kstammits/Mutable/Kinks/pics/pic_rear.jpeg

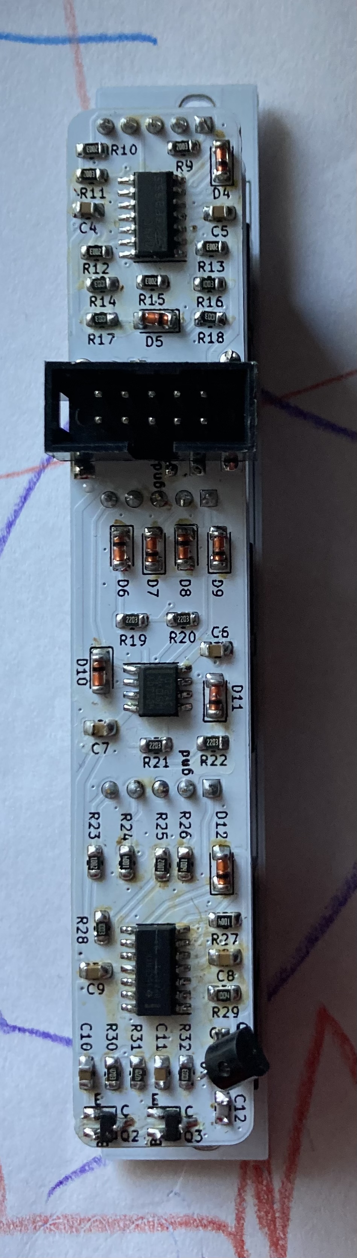
Kinks/pics/pic_rear.jpeg
