kstammits/Mutable/Kinks/pics/pic_face.jpeg

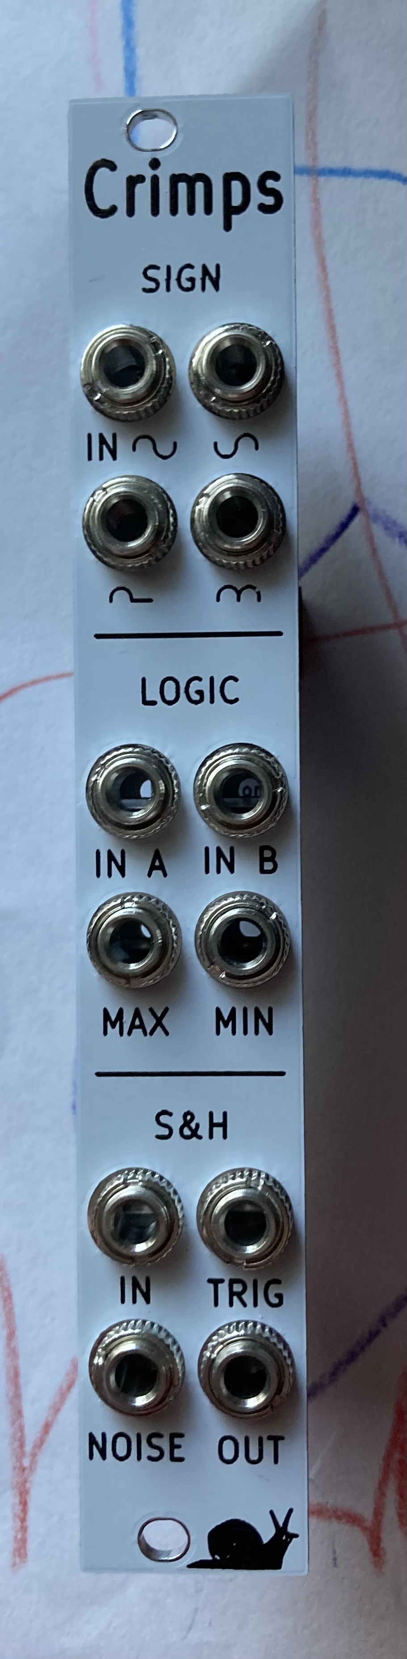
Kinks/pics/pic_face.jpeg
