kstammits/Mutable/Kinks/pics/pic_mg.jpeg

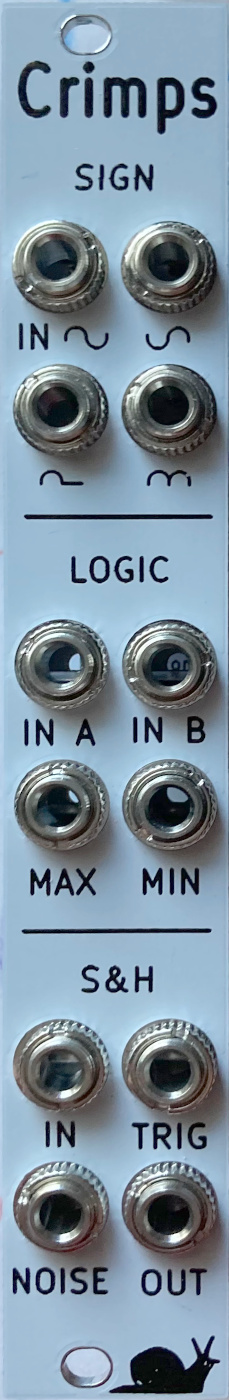
Kinks/pics/pic_mg.jpeg
