kstammits/Mutable/Kinks/pics/pic_side.jpeg

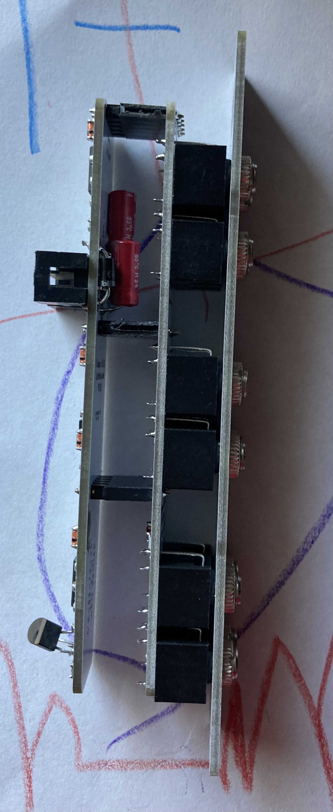
Kinks/pics/pic_side.jpeg
