kstammits/Mutable/Kinks/pics/pic_tri.jpeg

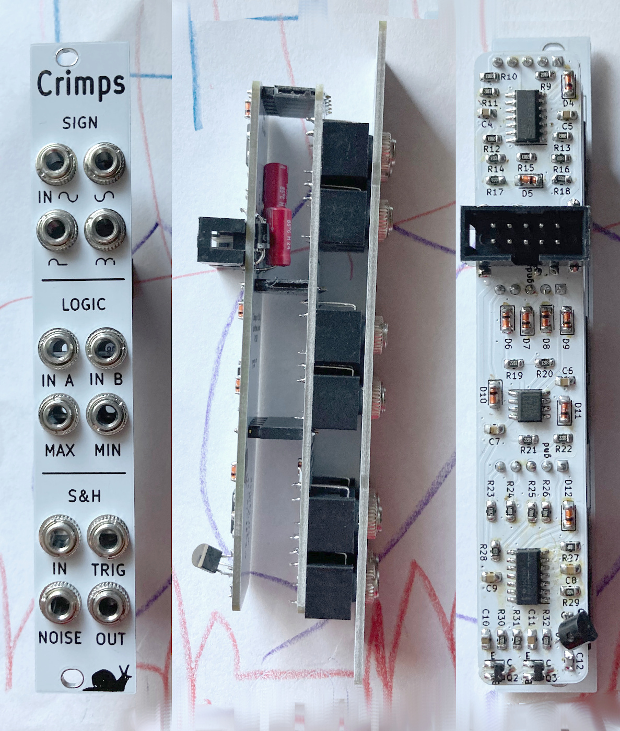
Kinks/pics/pic_tri.jpeg
