kstammits/Mutable/Kinks/pics/Screen Shot 2021-11-17 at 9.47.22 PM.png

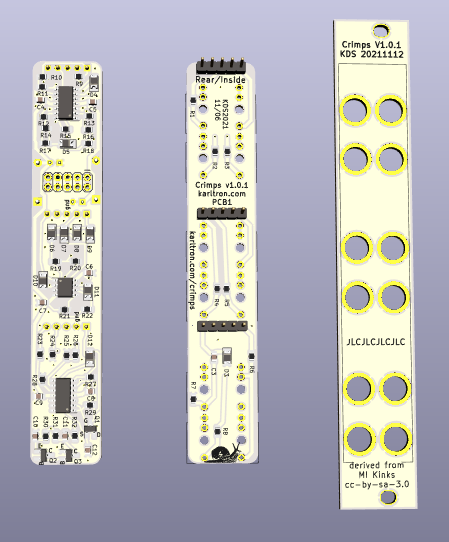
Kinks/pics/Screen Shot 2021-11-17 at 9.47.22 PM.png
