kstammits/Mutable/Shades/mg_shady.png

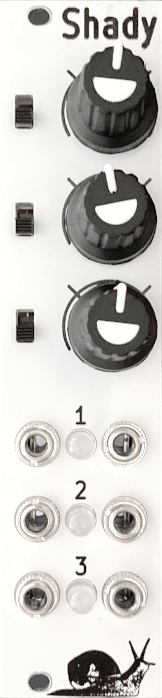
Shades/mg_shady.png
