kstammits/Mutable/Shades/sss_back.png

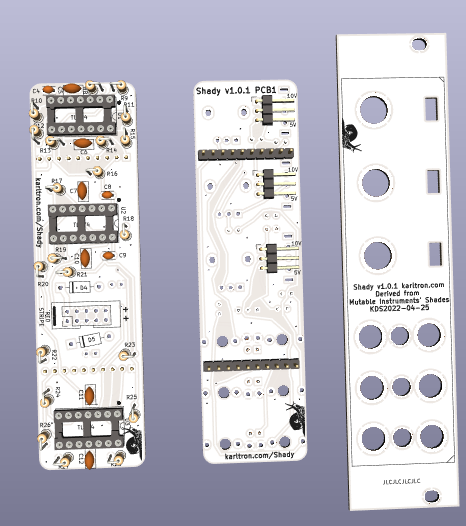
Shades/sss_back.png
