kstammits/Mutable/Shades/sss_front.png

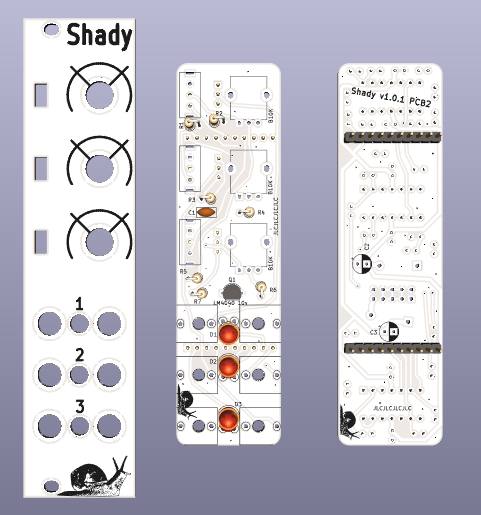
Shades/sss_front.png
