kstammits/Mutable/Kinks/bom/BOM.Guide.xlsx

Sheet: BOM
Source: | /Users/karl/Workspace/KiCad/Crimps/crimps/k2.sch
Date: | Thursday, November 18, 2021 at 08:59:49 PM
Tool: | Eeschema (5.1.10-1-10_14)
Generator: | /private/var/folders/6g/062y2qc95n76y3fy2wkwz5l40000gn/T/AppTranslocation/AF1E8601-DF93-40C0-9ED7-950A2D177542/d/kicad.app/Contents/SharedSupport/plugins/bom_csv_grouped_by_value.py
Component Count: | 81
Individual Components:
Item | Qty | Reference(s) | Value | LibPart | Footprint | Datasheet
 |  | C1 | 22u | k2-eagle-import:C-USC0805 | Capacitor_THT:CP_Radial_D6.3mm_P2.50mm
 |  | C2 | 22u | k2-eagle-import:C-USC0805 | Capacitor_THT:CP_Radial_D6.3mm_P2.50mm
 |  | C3 | 100p | device:C | Capacitor_SMD:C_0805_2012Metric_Pad1.18x1.45mm_HandSolder
 |  | C4 | 100n | k2-eagle-import:C-USC0402 | Capacitor_SMD:C_0805_2012Metric_Pad1.18x1.45mm_HandSolder
 |  | C5 | 100n | k2-eagle-import:C-USC0402 | Capacitor_SMD:C_0805_2012Metric_Pad1.18x1.45mm_HandSolder
 |  | C6 | 100n | k2-eagle-import:C-USC0805 | Capacitor_SMD:C_0805_2012Metric_Pad1.18x1.45mm_HandSolder
 |  | C7 | 100n | k2-eagle-import:C-USC0805 | Capacitor_SMD:C_0805_2012Metric_Pad1.18x1.45mm_HandSolder
 |  | C8 | 100n | k2-eagle-import:C-USC0402 | Capacitor_SMD:C_0805_2012Metric_Pad1.18x1.45mm_HandSolder
 |  | C9 | 100n | k2-eagle-import:C-USC0402 | Capacitor_SMD:C_0805_2012Metric_Pad1.18x1.45mm_HandSolder
 |  | C10 | 4.7u | k2-eagle-import:C-USC0603 | Capacitor_SMD:C_0805_2012Metric_Pad1.18x1.45mm_HandSolder
 |  | C11 | 100n | device:C | Capacitor_SMD:C_0805_2012Metric_Pad1.18x1.45mm_HandSolder
 |  | C12 | 10n | device:C | Capacitor_SMD:C_0805_2012Metric_Pad1.18x1.45mm_HandSolder
 |  | D1 | S1JL | Device:D | Diode_THT:D_DO-41_SOD81_P10.16mm_Horizontal
 |  | D2 | S1JL | Device:D | Diode_THT:D_DO-41_SOD81_P10.16mm_Horizontal
 |  | D3 | 1N4148 | device:D | Diode_SMD:D_1206_3216Metric_Pad1.42x1.75mm_HandSolder
 |  | D4 | 1N4148 | device:D | Diode_SMD:D_1206_3216Metric_Pad1.42x1.75mm_HandSolder
 |  | D5 | 1N4148 | device:D | Diode_SMD:D_1206_3216Metric_Pad1.42x1.75mm_HandSolder
 |  | D6 | 1N4148 | device:D | Diode_SMD:D_1206_3216Metric_Pad1.42x1.75mm_HandSolder
 |  | D7 | 1N4148 | device:D | Diode_SMD:D_1206_3216Metric_Pad1.42x1.75mm_HandSolder
 |  | D8 | 1N4148 | device:D | Diode_SMD:D_1206_3216Metric_Pad1.42x1.75mm_HandSolder
 |  | D9 | 1N4148 | device:D | Diode_SMD:D_1206_3216Metric_Pad1.42x1.75mm_HandSolder
 |  | D10 | 1N4148 | device:D | Diode_SMD:D_1206_3216Metric_Pad1.42x1.75mm_HandSolder
 |  | D11 | 1N4148 | device:D | Diode_SMD:D_1206_3216Metric_Pad1.42x1.75mm_HandSolder
 |  | D12 | 1N4148 | device:D | Diode_SMD:D_1206_3216Metric_Pad1.42x1.75mm_HandSolder
 |  | IC1 | TL074 | Amplifier_Operational:TL074 | Package_SO:SOIC-14_3.9x8.7mm_P1.27mm
 |  | IC2 | TL072 | Amplifier_Operational:TL072 | Package_SO:SOIC-8_3.9x4.9mm_P1.27mm
 |  | IC3 | TL074 | Amplifier_Operational:TL074 | Package_SO:SOIC-14_3.9x8.7mm_P1.27mm
 |  | J1 | PJ301_THONKICONN6 | k2-eagle-import:PJ301_THONKICONN6 | k2:WQP_PJ_301M6
 |  | J2 | PJ301_THONKICONN6 | k2-eagle-import:PJ301_THONKICONN6 | k2:WQP_PJ_301M6
 |  | J3 | PJ301_THONKICONN6 | k2-eagle-import:PJ301_THONKICONN6 | k2:WQP_PJ_301M6
 |  | J4 | PJ301_THONKICONN6 | k2-eagle-import:PJ301_THONKICONN6 | k2:WQP_PJ_301M6
 |  | J5 | PJ301_THONKICONN6 | k2-eagle-import:PJ301_THONKICONN6 | k2:WQP_PJ_301M6
 |  | J6 | PJ301_THONKICONN6 | k2-eagle-import:PJ301_THONKICONN6 | k2:WQP_PJ_301M6
 |  | J7 | PJ301_THONKICONN6 | k2-eagle-import:PJ301_THONKICONN6 | k2:WQP_PJ_301M6
 |  | J8 | PJ301_THONKICONN6 | k2-eagle-import:PJ301_THONKICONN6 | k2:WQP_PJ_301M6
 |  | J9 | PJ301_THONKICONN6 | k2-eagle-import:PJ301_THONKICONN6 | k2:WQP_PJ_301M6
 |  | J10 | PJ301_THONKICONN6 | k2-eagle-import:PJ301_THONKICONN6 | k2:WQP_PJ_301M6
 |  | J11 | PJ301_THONKICONN6 | k2-eagle-import:PJ301_THONKICONN6 | k2:WQP_PJ_301M6
 |  | J12 | PJ301_THONKICONN6 | k2-eagle-import:PJ301_THONKICONN6 | k2:WQP_PJ_301M6
 |  | J13 | Conn_01x05_Female | Connector:Conn_01x05_Female | Connector_PinHeader_2.54mm:PinHeader_1x05_P2.54mm_Vertical | ~
 |  | J14 | Conn_01x05_Female | Connector:Conn_01x05_Female | Connector_PinHeader_2.54mm:PinHeader_1x05_P2.54mm_Vertical | ~
 |  | J15 | Conn_01x05_Female | Connector:Conn_01x05_Female | Connector_PinHeader_2.54mm:PinHeader_1x05_P2.54mm_Vertical | ~
 |  | J16 | Conn_01x05_Male | Connector:Conn_01x05_Male | Connector_PinHeader_2.54mm:PinHeader_1x05_P2.54mm_Vertical | ~
 |  | J17 | Conn_01x05_Male | Connector:Conn_01x05_Male | Connector_PinHeader_2.54mm:PinHeader_1x05_P2.54mm_Vertical | ~
 |  | J18 | Conn_01x05_Male | Connector:Conn_01x05_Male | Connector_PinHeader_2.54mm:PinHeader_1x05_P2.54mm_Vertical | ~
 |  | JP1 | M05X2PTH | k2-eagle-import:M05X2PTH | k2:AVR_ICSP
 |  | Q1 | MMBFJ309 | device:Q_NJFET_SDG | Package_TO_SOT_SMD:SOT-23_Handsoldering
 |  | Q2 | MMBT3904 | device:Q_NPN_EBC | Package_TO_SOT_SMD:SOT-23_Handsoldering
 |  | Q3 | MMBT3904 | device:Q_NPN_EBC | Package_TO_SOT_SMD:SOT-23_Handsoldering
 |  | R1 | 180 | k2-eagle-import:R-US_R0402 | Resistor_SMD:R_0805_2012Metric_Pad1.20x1.40mm_HandSolder
 |  | R2 | 180 | k2-eagle-import:R-US_R0402 | Resistor_SMD:R_0805_2012Metric_Pad1.20x1.40mm_HandSolder
 |  | R3 | 180 | k2-eagle-import:R-US_R0402 | Resistor_SMD:R_0805_2012Metric_Pad1.20x1.40mm_HandSolder
 |  | R4 | 180 | k2-eagle-import:R-US_R0402 | Resistor_SMD:R_0805_2012Metric_Pad1.20x1.40mm_HandSolder
 |  | R5 | 180 | k2-eagle-import:R-US_R0402 | Resistor_SMD:R_0805_2012Metric_Pad1.20x1.40mm_HandSolder
 |  | R6 | 180 | k2-eagle-import:R-US_R0402 | Resistor_SMD:R_0805_2012Metric_Pad1.20x1.40mm_HandSolder
 |  | R7 | 100k | k2-eagle-import:R-US_R0402 | Resistor_SMD:R_0805_2012Metric_Pad1.20x1.40mm_HandSolder
 |  | R8 | 180 | k2-eagle-import:R-US_R0402 | Resistor_SMD:R_0805_2012Metric_Pad1.20x1.40mm_HandSolder
 |  | R9 | 200k | k2-eagle-import:R-US_R0402 | Resistor_SMD:R_0805_2012Metric_Pad1.20x1.40mm_HandSolder
 |  | R10 | 200k | k2-eagle-import:R-US_R0402 | Resistor_SMD:R_0805_2012Metric_Pad1.20x1.40mm_HandSolder
 |  | R11 | 200k | k2-eagle-import:R-US_R0402 | Resistor_SMD:R_0805_2012Metric_Pad1.20x1.40mm_HandSolder
 |  | R12 | 200k | k2-eagle-import:R-US_R0402 | Resistor_SMD:R_0805_2012Metric_Pad1.20x1.40mm_HandSolder
 |  | R13 | 200k | k2-eagle-import:R-US_R0402 | Resistor_SMD:R_0805_2012Metric_Pad1.20x1.40mm_HandSolder
 |  | R14 | 100k | k2-eagle-import:R-US_R0402 | Resistor_SMD:R_0805_2012Metric_Pad1.20x1.40mm_HandSolder
 |  | R15 | 200k | k2-eagle-import:R-US_R0402 | Resistor_SMD:R_0805_2012Metric_Pad1.20x1.40mm_HandSolder
 |  | R16 | 100k | k2-eagle-import:R-US_R0402 | Resistor_SMD:R_0805_2012Metric_Pad1.20x1.40mm_HandSolder
 |  | R17 | 100k | k2-eagle-import:R-US_R0402 | Resistor_SMD:R_0805_2012Metric_Pad1.20x1.40mm_HandSolder
 |  | R18 | 100k | k2-eagle-import:R-US_R0402 | Resistor_SMD:R_0805_2012Metric_Pad1.20x1.40mm_HandSolder
 |  | R19 | 220k | k2-eagle-import:R-US_R0402 | Resistor_SMD:R_0805_2012Metric_Pad1.20x1.40mm_HandSolder
 |  | R20 | 220k | k2-eagle-import:R-US_R0402 | Resistor_SMD:R_0805_2012Metric_Pad1.20x1.40mm_HandSolder
 |  | R21 | 220k | k2-eagle-import:R-US_R0402 | Resistor_SMD:R_0805_2012Metric_Pad1.20x1.40mm_HandSolder
 |  | R22 | 220k | k2-eagle-import:R-US_R0402 | Resistor_SMD:R_0805_2012Metric_Pad1.20x1.40mm_HandSolder
 |  | R23 | 10k | k2-eagle-import:R-US_R0402 | Resistor_SMD:R_0805_2012Metric_Pad1.20x1.40mm_HandSolder
 |  | R24 | 1.0M | k2-eagle-import:R-US_R0402 | Resistor_SMD:R_0805_2012Metric_Pad1.20x1.40mm_HandSolder
 |  | R25 | 10k | k2-eagle-import:R-US_R0402 | Resistor_SMD:R_0805_2012Metric_Pad1.20x1.40mm_HandSolder
 |  | R26 | 1.0M | k2-eagle-import:R-US_R0402 | Resistor_SMD:R_0805_2012Metric_Pad1.20x1.40mm_HandSolder
 |  | R27 | 1.5M | k2-eagle-import:R-US_R0402 | Resistor_SMD:R_0805_2012Metric_Pad1.20x1.40mm_HandSolder
 |  | R28 | 100k | k2-eagle-import:R-US_R0402 | Resistor_SMD:R_0805_2012Metric_Pad1.20x1.40mm_HandSolder
 |  | R29 | 1.0M | k2-eagle-import:R-US_R0402 | Resistor_SMD:R_0805_2012Metric_Pad1.20x1.40mm_HandSolder
 |  | R30 | 470k | k2-eagle-import:R-US_R0402 | Resistor_SMD:R_0805_2012Metric_Pad1.20x1.40mm_HandSolder
 |  | R31 | 4.7k | k2-eagle-import:R-US_R0402 | Resistor_SMD:R_0805_2012Metric_Pad1.20x1.40mm_HandSolder
 |  | R32 | 100k | k2-eagle-import:R-US_R0402 | Resistor_SMD:R_0805_2012Metric_Pad1.20x1.40mm_HandSolder
Collated Components:
Item | Qty | Reference(s) | Value | LibPart | Footprint | Datasheet
1 | 2 | C1, C2 | 22u | k2-eagle-import:C-USC0805 | Capacitor_THT:CP_Radial_D6.3mm_P2.50mm
2 | 1 | C3 | 100p | device:C | Capacitor_SMD:C_0805_2012Metric_Pad1.18x1.45mm_HandSolder
3 | 4 | C4, C5, C8, C9 | 100n | k2-eagle-import:C-USC0402 | Capacitor_SMD:C_0805_2012Metric_Pad1.18x1.45mm_HandSolder
4 | 2 | C6, C7 | 100n | k2-eagle-import:C-USC0805 | Capacitor_SMD:C_0805_2012Metric_Pad1.18x1.45mm_HandSolder
5 | 1 | C10 | 4.7u | k2-eagle-import:C-USC0603 | Capacitor_SMD:C_0805_2012Metric_Pad1.18x1.45mm_HandSolder
6 | 1 | C11 | 100n | device:C | Capacitor_SMD:C_0805_2012Metric_Pad1.18x1.45mm_HandSolder
7 | 1 | C12 | 10n | device:C | Capacitor_SMD:C_0805_2012Metric_Pad1.18x1.45mm_HandSolder
8 | 2 | D1, D2 | S1JL | Device:D | Diode_THT:D_DO-41_SOD81_P10.16mm_Horizontal
9 | 10 | D3, D4, D5, D6, D7, D8, D9, D10, D11, D12 | 1N4148 | device:D | Diode_SMD:D_1206_3216Metric_Pad1.42x1.75mm_HandSolder
10 | 2 | IC1, IC3 | TL074 | Amplifier_Operational:TL074 | Package_SO:SOIC-14_3.9x8.7mm_P1.27mm
11 | 1 | IC2 | TL072 | Amplifier_Operational:TL072 | Package_SO:SOIC-8_3.9x4.9mm_P1.27mm
12 | 12 | J1, J2, J3, J4, J5, J6, J7, J8, J9, J10, J11, J12 | PJ301_THONKICONN6 | k2-eagle-import:PJ301_THONKICONN6 | k2:WQP_PJ_301M6
13 | 3 | J13, J14, J15 | Conn_01x05_Female | Connector:Conn_01x05_Female | Connector_PinHeader_2.54mm:PinHeader_1x05_P2.54mm_Vertical | ~
14 | 3 | J16, J17, J18 | Conn_01x05_Male | Connector:Conn_01x05_Male | Connector_PinHeader_2.54mm:PinHeader_1x05_P2.54mm_Vertical | ~
15 | 1 | JP1 | M05X2PTH | k2-eagle-import:M05X2PTH | k2:AVR_ICSP
16 | 1 | Q1 | MMBFJ309 | device:Q_NJFET_SDG | Package_TO_SOT_SMD:SOT-23_Handsoldering
17 | 2 | Q2, Q3 | MMBT3904 | device:Q_NPN_EBC | Package_TO_SOT_SMD:SOT-23_Handsoldering
18 | 7 | R1, R2, R3, R4, R5, R6, R8 | 180 | k2-eagle-import:R-US_R0402 | Resistor_SMD:R_0805_2012Metric_Pad1.20x1.40mm_HandSolder
19 | 7 | R7, R14, R16, R17, R18, R28, R32 | 100k | k2-eagle-import:R-US_R0402 | Resistor_SMD:R_0805_2012Metric_Pad1.20x1.40mm_HandSolder
20 | 6 | R9, R10, R11, R12, R13, R15 | 200k | k2-eagle-import:R-US_R0402 | Resistor_SMD:R_0805_2012Metric_Pad1.20x1.40mm_HandSolder
21 | 4 | R19, R20, R21, R22 | 220k | k2-eagle-import:R-US_R0402 | Resistor_SMD:R_0805_2012Metric_Pad1.20x1.40mm_HandSolder
22 | 2 | R23, R25 | 10k | k2-eagle-import:R-US_R0402 | Resistor_SMD:R_0805_2012Metric_Pad1.20x1.40mm_HandSolder
23 | 3 | R24, R26, R29 | 1.0M | k2-eagle-import:R-US_R0402 | Resistor_SMD:R_0805_2012Metric_Pad1.20x1.40mm_HandSolder
24 | 1 | R27 | 1.5M | k2-eagle-import:R-US_R0402 | Resistor_SMD:R_0805_2012Metric_Pad1.20x1.40mm_HandSolder
25 | 1 | R30 | 470k | k2-eagle-import:R-US_R0402 | Resistor_SMD:R_0805_2012Metric_Pad1.20x1.40mm_HandSolder
26 | 1 | R31 | 4.7k | k2-eagle-import:R-US_R0402 | Resistor_SMD:R_0805_2012Metric_Pad1.20x1.40mm_HandSolder

Sheet: GUIDE
Crimps v122 karltron.com December 2021 - Derived from Mutable Kinks v4.1 cc-by-sa
Step | Qty | Reference(s) | Value | Footprint | Note
1 | 7 | R1, R2, R3, R4, R5, R6, R8 | 180R | 0805 plain | output protections, could be 100R to 1K
2 | 7 | R7, R14, R16, R17, R18, R28, R32 | 100k | 0805 plain
3 | 6 | R9, R10, R11, R12, R13, R15 | 200k | 0805 plain
4 | 4 | R19, R20, R21, R22 | 220k | 0805 plain
5 | 2 | R23, R25 | 10k | 0805 plain
6 | 3 | R24, R26, R29 | 1.0M | 0805 plain
7 | 2 | R27, R30 | 470k | 0805 plain | R27 sets noise volume
8 | 1 | R31 | 4.7k | 0805 plain
9 | 1 | C3 | 100p | 0805 plain | trigger conditioning
10 | 7 | C4, C5, C6, C7, C8, C9,C11 | 100n | 0805 plain
11 | 1 | C10 | 4.7u | 0805 plain | buffer before noise generator, value not critical
12 | 1 | C12 | 10n | 0805 C0G special | sample/hold
13 | 10 | D3, D4, D5, D6, D7, D8, D9, D10, D11, D12 | 1N4148 or FDLL4148 | Diode_SMD:D_1206_3216Metric_Pad1.42x1.75mm_HandSolder | FDLL4148 or generic signal diode
14 | 1 | IC3 | OPA4171 | SOIC-14_3.9x8.7mm_P1.27mm | a tl074 almost works but the fancy opamp is better
15 | 1 | IC1 | TL074 | SOIC-14_3.9x8.7mm_P1.27mm
16 | 1 | IC2 | TL072 | SOIC-8_3.9x4.9mm_P1.27mm
17 | 1 | Q1 | MMBFJ309 | SOT-23 | J112 and MMBF4392 work too
18 | 2 | Q2, Q3 | MMBT3904 | SOT-23 | NPN Plain
19 | 1 | JP1 | M05X2PTH | power connector 2x5 | shrouded fits
20 | 2 | C1, C2 | 22u | Cap_THT:D6.3mm_P2.50mm | pre-bend to lay flat on board inside
21 | 2 | D1, D2 | 1N4001 or 1N5819 | Diode_THT:D_DO-41_SOD81 | reverse power protection optional, could jumper these with wire instead of series diode drop
22 | 3 | J13, J14, J15 | Conn_01x05_Female | Connector_PinHeader_2.54mm:PinHeader_1x05_P2.54mm_Vertical
23 | 3 | J16, J17, J18 | Conn_01x05_Male | Connector_PinHeader_2.54mm:PinHeader_1x05_P2.54mm_Vertical
24 | 12 | J1, J2, J3, J4, J5, J6, J7, J8, J9, J10, J11, J12 | PJ301 THONKICONN | Switching Mono-Jack

Sheet: Costing
Step | Qty | Reference(s) | Value | Footprint | Note | Shopping | Cost Estimate | Extended
1 | 7 | R1, R2, R3, R4, R5, R6, R8 | 180R | 0805 plain |  | incoming Mouser | $0.01 | $0.07
2 | 7 | R7, R14, R16, R17, R18, R28, R32 | 100k | 0805 plain |  |  | $0.01 | $0.07 | Packing/Picking | PCB Set | Total Kit Price estimate
3 | 6 | R9, R10, R11, R12, R13, R15 | 200k | 0805 plain |  | incoming Mouser | $0.01 | $0.06 | $30.00 | $20.00 | $67.67
4 | 4 | R19, R20, R21, R22 | 220k | 0805 plain |  |  | $0.01 | $0.04
5 | 2 | R23, R25 | 10k | 0805 plain |  |  | $0.01 | $0.02
6 | 3 | R24, R26, R29 | 1.0M | 0805 plain |  |  | $0.01 | $0.03
7 | 1 | R27 | 1.5M | 0805 plain | change to 1M |  | $0.01 | $0.01
8 | 1 | R30 | 470k | 0805 plain |  |  | $0.01 | $0.01
9 | 1 | R31 | 4.7k | 0805 plain |  |  | $0.01 | $0.01
10 | 1 | C3 | 100p | 0805 plain |  | incoming Mouser | $0.04 | $0.04
11 | 6 | C4, C5, C6, C7, C8, C9,C11 | 100n | 0805 plain |  |  | $0.02 | $0.12
12 | 1 | C10 | 4.7u | 0805 plain | buffer before noise generator, value not critical |  | $0.10 | $0.10
13 | 1 | C12 | 10n | 0805 C0G special | sample/hold | incoming Mouser | $0.15 | $0.15
14 | 10 | D3, D4, D5, D6, D7, D8, D9, D10, D11, D12 | 1N4148 or FDLL4148 | Diode_SMD:D_1206_3216Metric_Pad1.42x1.75mm_HandSolder | FDLL4148 or generic signal diode |  | $0.04 | $0.40
15 | 1 | IC3 | OPA4147 or maybe TL074 IDK | Package_SO:SOIC-14_3.9x8.7mm_P1.27mm |  | incoming Mouser | $3.00 | $3.00
16 | 1 | IC1 | TL074 | Package_SO:SOIC-14_3.9x8.7mm_P1.27mm |  |  | $0.50 | $0.50
17 | 1 | IC2 | TL072 | Package_SO:SOIC-8_3.9x4.9mm_P1.27mm |  |  | $0.50 | $0.50
18 | 1 | Q1 | MMBFJ309 | SOT-23 | jfet | incoming eBay 2022 | $0.30 | $0.30
19 | 2 | Q2, Q3 | MMBT3904 | SOT-23 | NPN Plain |  | $0.10 | $0.20
20 | 2 | C1, C2 | 22u | Capacitor_THT:CP_Radial_D6.3mm_P2.50mm |  |  | $0.30 | $0.60
21 | 2 | D1, D2 | 1N4001 or 1N5819 | Diode_THT:D_DO-41_SOD81 | reverse power protection optional, could jumper these with wire instead of series diode drop |  | $0.20 | $0.40
22 | 3 | J13, J14, J15 | Conn_01x05_Female | Connector_PinHeader_2.54mm:PinHeader_1x05_P2.54mm_Vertical |  |  | $0.15 | $0.45
23 | 3 | J16, J17, J18 | Conn_01x05_Male | Connector_PinHeader_2.54mm:PinHeader_1x05_P2.54mm_Vertical |  |  | $0.15 | $0.45
24 | 1 | JP1 | M05X2PTH | power connector 2x5 | shrouded should fit |  | $0.25 | $0.25
25 | 12 | J1, J2, J3, J4, J5, J6, J7, J8, J9, J10, J11, J12 | PJ301_THONKICONN6 | Switching Mono-Jack |  |  | $0.25 | $3.00
 | 1 | power cable |  |  |  |  | $1.00 | $1.00
 |  | PCBs
