kstammits/Mutable/Beads/beads_v51.csv

Reference | Qty | Value | Footprint | Datasheet | Note
C1,C2 | 2 | 10u | beads_v51:C0805
C3,C4,C6,C7,C16,C18,C28,C29 | 8 | 10u | beads_v51:C0603
C5,C9,C12,C13,C14,C15,C21,C22,C25,C26,C27,C30,C33,C36,C41,C42,C45,C46,C47,C48,C50,C52,C53,C56,C58,C61,C62,C63,C65,C67,C68,C70,C71 | 33 | 100n | beads_v51:C0402
C8,C11,C19 | 3 | 1.0n | beads_v51:C0402
C10,C17,C66,C69,C72 | 5 | 2.2u | beads_v51:C0402
C20,C23,C24 | 3 | 2.2n | beads_v51:C0402
C31,C32,C37,C40 | 4 | 220p | beads_v51:C0402
C34,C35 | 2 | 2.2n | beads_v51:C0603
C38,C39,C64 | 3 | 1.2n | beads_v51:C0402
C43,C44 | 2 | 680p | beads_v51:C0402
C49,C51 | 2 | 330p | beads_v51:C0402
C54,C55,C59 | 3 | 47u | beads_v51:C0805
C57,C60 | 2 | 18p | beads_v51:C0402
D1,D2 | 2 | 1N5819HW | beads_v51:SOD123 | https://www.digikey.com/en/products/detail/diodes-incorporated/1N5819HW-7-F/814970 | shottkey power inlet
D3 | 1 | BAT54S | beads_v51:SOT23 | https://www.digikey.com/en/products/detail/onsemi/BAT54SLT1G/918317 | shottkey pair for 3v3 protection
D4,D5,D6,D7,D8,D9,D10,D11,D12,D13,D14,D15 | 12 | 16V | beads_v51:0603 | https://www.digikey.com/en/products/detail/yageo/SMBJ16CA-TR13/13689531 | ESD 16V zener
IC1 | 1 | MCP16311MS | beads_v51:MSOP-8 | https://www.digikey.com/en/products/detail/microchip-technology/MCP16311T-E-MS/4079992 | buck regulator
IC2,IC4 | 2 | MCP6004 | beads_v51:TSSOP14_065 | https://www.digikey.com/en/products/filter/linear/amplifiers/instrumentation-op-amps-buffer-amps/687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 | 3v3 opamp
IC3 | 1 | LM4040B10 | beads_v51:DBZ_R-PDSO-G3 | https://www.digikey.com/en/products/filter/power-management-pmic/voltage-reference/693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 | 10v reference
IC5 | 1 | LD2981ABU33 | beads_v51:SOT89 | https://www.digikey.com/en/products/detail/stmicroelectronics/LD2981ABU33TR/591626 | IC REG LINEAR 3.3V 100MA SOT89-3
IC6 | 1 | UA78MDCY05 | beads_v51:SOT223 |  | 5v reg | DCY is SOT223
IC7 | 1 | PCM3060 | beads_v51:TSSOP28 | https://www.digikey.com/en/products/detail/texas-instruments/PCM3060PWR/1900019 | CODEC
IC8 | 1 | 4051PW | beads_v51:TSSOP16_065 | https://www.digikey.com/en/products/filter/interface/analog-switches-multiplexers-demultiplexers/747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 | 8-1 mux
IC9,IC10 | 2 | NJM2068 | beads_v51:TSSOP08 | https://www.digikey.com/en/products/filter/instrumentation-op-amps-buffer-amps/687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 | dual opamp
IC11 | 1 | STM32H743VIT6 | beads_v51:TQFP100 | https://www.digikey.com/en/products/detail/stmicroelectronics/STM32H743VIT6/7809237
J1,J2,J3,J4,J5,J6,J7,J8,J9,J10,J11,J12 | 12 | PJ301_THONKICONNTME | beads_v51:WQP_PJ_301M_TME |  | jack
JP1 | 1 | M05X2SHD | beads_v51:2X5-SHROUDED |  | power inlet
JP2 | 1 | M04PTH | beads_v51:1X04 |  | programming header
JP3 | 1 | M02PTH | beads_v51:1X02 |  | rxtx header
L1,L2,L5,L6,L7,L11,L12 | 7 | 1k@1MHz | beads_v51:0603 |  | ferrite bead
L3 | 1 | 15u/0.73A | beads_v51:R1210 |  | ferrite bead
L4 | 1 | 1u/0.75A | beads_v51:R1210 |  | ferrite bead
LED1 | 1 | ASMB-KTF0-0A306 | beads_v51:PLCC-4-2220
LED2,LED3,LED4,LED5 | 4 | INL-3AW30 | beads_v51:LED3MM
Q1 | 1 | 8MHz | beads_v51:CTS406
R1,R4 | 2 | 39 | beads_v51:R0402
R2,R3,R90 | 3 | 220 | beads_v51:R0402
R5,R11,R14,R15,R17,R36,R49,R68,R70,R75,R80,R81,R82,R83,R84 | 15 | 10k | beads_v51:R0402
R6 | 1 | 31.6k | beads_v51:R0402
R7,R22,R23,R44,R45 | 5 | 10kB | beads_v51:ALPS_POT_VERTICAL_PS
R8,R21,R29,R33,R35,R38,R78,R79,R87,R88 | 10 | 100k | beads_v51:R0402
R9,R12,R18,R19,R30 | 5 | 33k | beads_v51:R0402
R10,R20,R56,R57,R58,R59 | 6 | 1.0k | beads_v51:R0402
R13,R16,R28 | 3 | 200k | beads_v51:R0402
R24,R25,R26,R27,R67,R69,R91,R92,R93,R94 | 10 | 2.0k | beads_v51:R0402
R31,R40,R41 | 3 | 20k | beads_v51:R0402
R32,R37 | 2 | 33 | beads_v51:R1206
R34,R39,R42 | 3 | 120k | beads_v51:R0402
R43,R46,R62,R63,R64,R65,R66 | 7 | 10kB | beads_v51:ALPS_POT_NARROW
R47,R89,R95 | 3 | 100 | beads_v51:R0402
R48 | 1 | 220k | beads_v51:R0402
R50,R51,R52,R53,R73,R74 | 6 | 12k | beads_v51:R0402
R54,R55,R60,R61 | 4 | 30k | beads_v51:R0402
R71,R72 | 2 | 8.2k | beads_v51:R0402
R76,R77 | 2 | 1.0k | beads_v51:R0603
R85,R86 | 2 | 1.0M | beads_v51:R0402
SW1,SW2 | 2 | LP4OA1PBCT | beads_v51:LP4OA1PBCT | DPDT with a light for tap tempo. But we don't use the dual throw so it is replacable w a single button and a LED.
SW3,SW4 | 2 | TAC_SWITCHSMD_JLEAD | beads_v51:TACTILE_SWITCH_SMD_JLEAD
