kstammits/Mutable/Jinx/Jinx.kicad_pcb

## KiCad design Jinx/Jinx.kicad_pcb (2026-11-04)

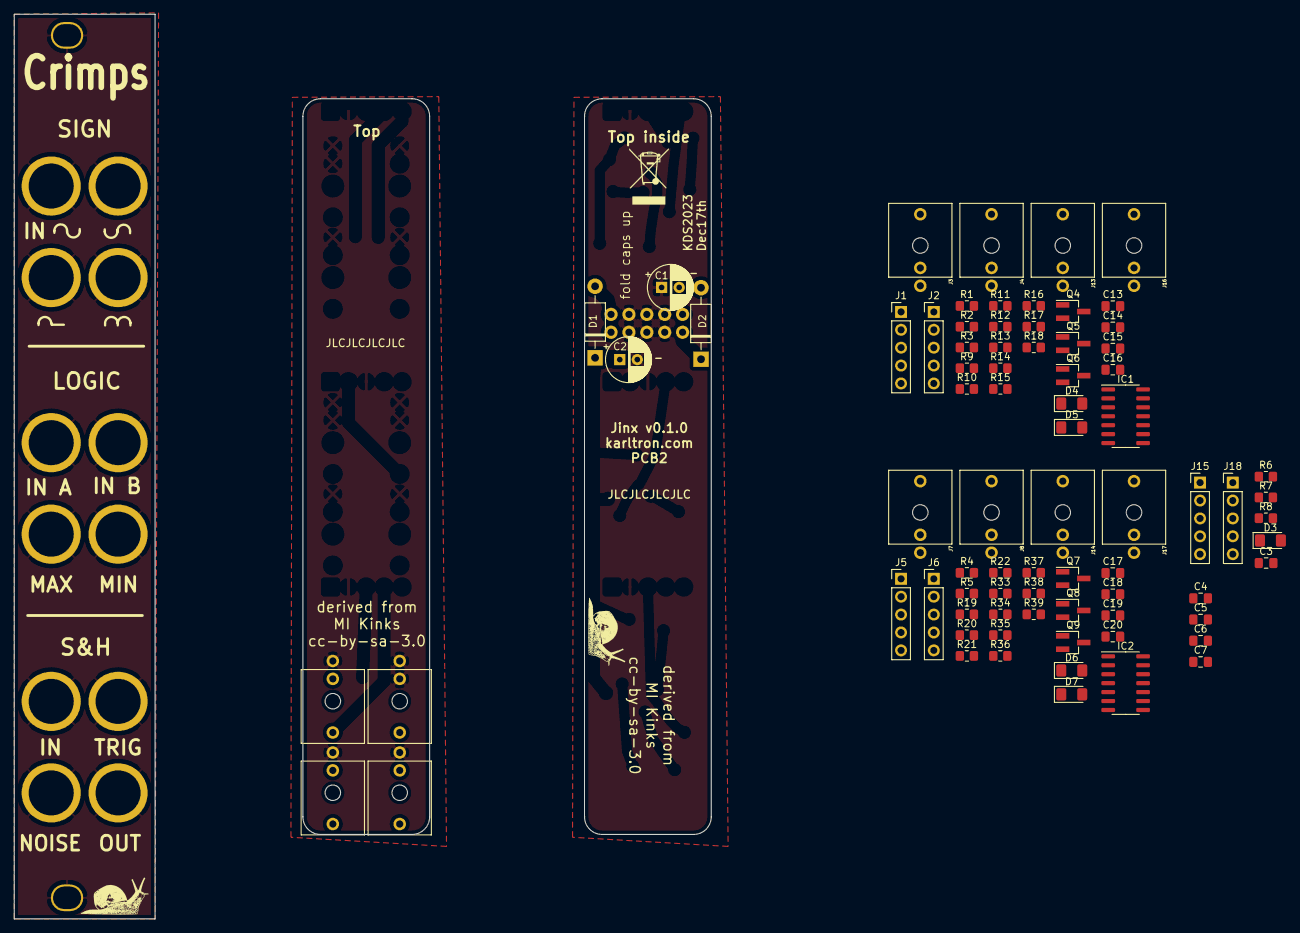
[picture p11: board Jinx.kicad_pcb from above]

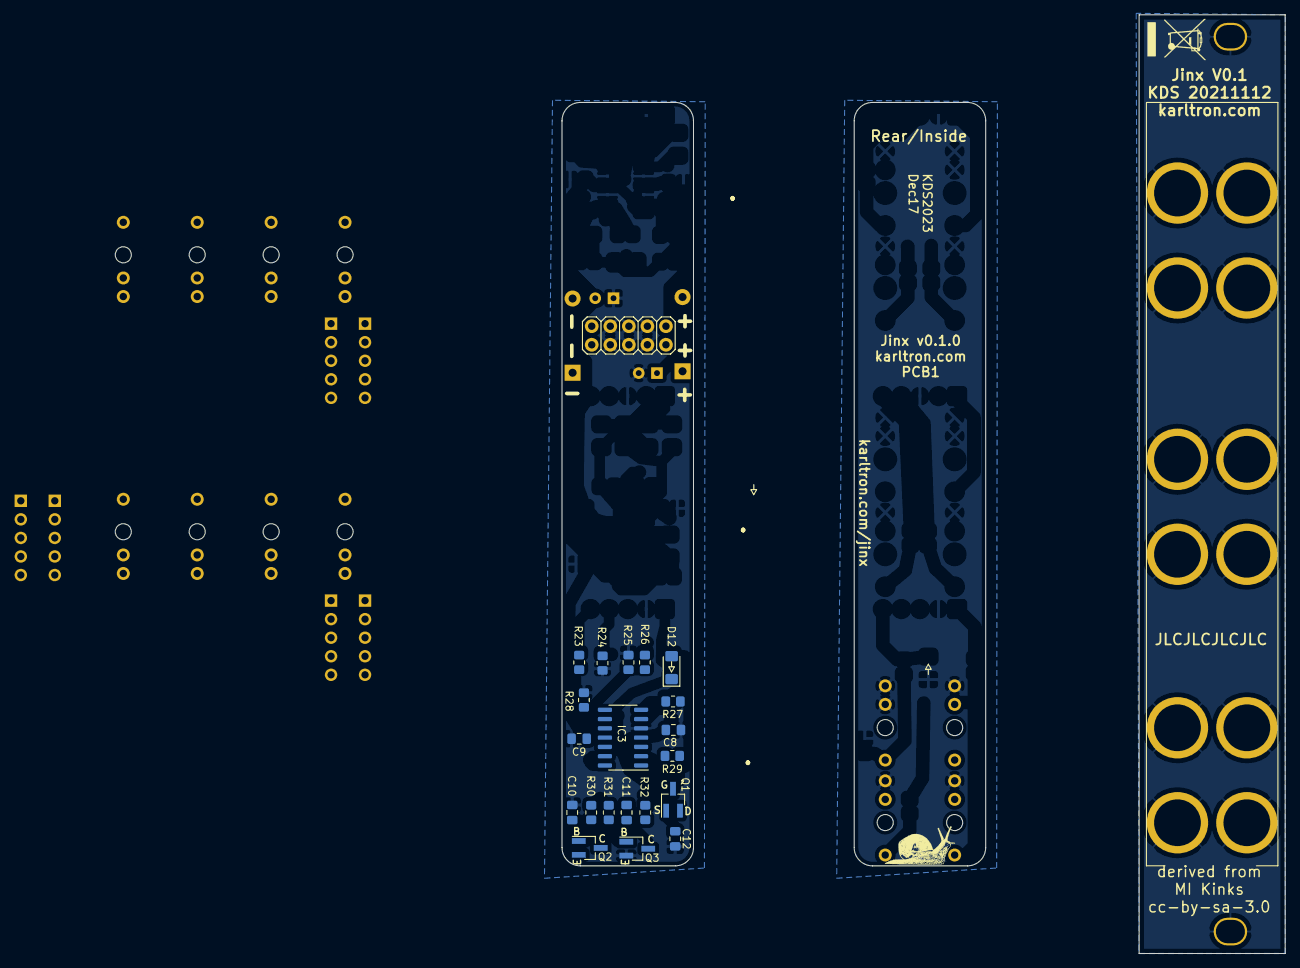
[picture p12: board Jinx.kicad_pcb from below]

Board: 2 copper layers, 113 parts (21 on the bottom side), 55 nets, no tracks yet.

Parts:
C1, C2: 22u; CP_Radial_D6.3mm_P2.50mm
C3, C16, C20: 100p; C_0805_2012Metric_Pad1.18x1.45mm_HandSolder
C4, C5, C6, C7, C8, C9, C11, C13, C17: 100n; C_0805_2012Metric_Pad1.18x1.45mm_HandSolder
C10, C14, C18: 4.7u; C_0805_2012Metric_Pad1.18x1.45mm_HandSolder
C12, C15, C19: 10n; C_0805_2012Metric_Pad1.18x1.45mm_HandSolder
D1, D2: S1JL; D_DO-41_SOD81_P10.16mm_Horizontal
D3, D4, D5, D6, D7, D12: 1N4148; D_1206_3216Metric_Pad1.42x1.75mm_HandSolder
G1: Logo_Open_Hardware_Small; snail4.sm
H1, H14: MountingHole_Pad; SLOT-1
H2, H2#2, H2#3, H2#4, H2#5, H2#6, H2#7, H2#8, H2#9: J1; MountingHole_6.4mm_M6_Pad
H6, H6#2, H6#3: J2; MountingHole_6.4mm_M6_Pad
IC1, IC2, IC3: TL074; SOIC-14_3.9x8.7mm_P1.27mm
J1, J5, J18: Conn_01x05_Male; PinHeader_1x05_P2.54mm_Vertical
J2, J6, J15: Conn_01x05_Female; PinHeader_1x05_P2.54mm_Vertical
J3, J4, J7, J8, J9, J10, J11, J12, J13, J14, J16, J17: PJ301_THONKICONN6; WQP_PJ_301M6
JP1: M05X2PTH; AVR_ICSP
Q1, Q6, Q9: MMBFJ309; SOT-23_Handsoldering
Q2, Q3, Q4, Q5, Q7, Q8: MMBT3904; SOT-23_Handsoldering
R1, R4, R30: 470k; R_0805_2012Metric_Pad1.20x1.40mm_HandSolder
R2, R5, R31: 4.7k; R_0805_2012Metric_Pad1.20x1.40mm_HandSolder
R3, R19, R27: 470K; R_0805_2012Metric_Pad1.20x1.40mm_HandSolder
R6, R8, R10, R11, R21, R22: 180; R_0805_2012Metric_Pad1.20x1.40mm_HandSolder
R7, R9, R16, R17, R20, R28, R32, R37, R38: 100k; R_0805_2012Metric_Pad1.20x1.40mm_HandSolder
R12, R13, R14, R24, R26, R29, R33, R34, R35: 1.0M; R_0805_2012Metric_Pad1.20x1.40mm_HandSolder
R15, R18, R23, R25, R36, R39: 10k; R_0805_2012Metric_Pad1.20x1.40mm_HandSolder

Connections:
GND: C1.1, C2.2, C4.1, C5.2, C6.2, C7.1, C8.2, C9.1, C10.2, C12.2, C14.2, C15.2, C18.2, C19.2, D3.2 (A), D5.2 (A), D7.2 (A), H1.1, H2.1, H2#2.1, H2#3.1, H2#4.1, H2#5.1, H2#6.1, H2#7.1, H2#8.1, H2#9.1, H6.1, H6#2.1, H6#3.1, H14.1, IC1.5 (+), IC2.5 (+), IC3.5 (+), J1.2, J2.2, J3.P1 (1), J4.P1 (1), J5.2, J6.2, J7.P1 (1), J8.P1 (1), J9.P1 (1), J10.P1 (1), J10.P2 (2), J11.P1 (1), J12.P1 (1), J13.P1 (1), J14.P1 (1), J15.2, J16.P1 (1), J16.P2 (2), J17.P1 (1), J17.P2 (2), J18.2, JP1.3, JP1.4, JP1.5, JP1.6, JP1.7, JP1.8, Q3.2 (E), Q5.2 (E), Q8.2 (E), R7.1, R13.2, R16.1, R17.1, R18.1, R24.2, R25.1, R28.1, R34.2, R37.1, R38.1, R39.1
unnamed: C11.2, R32.2
unnamed: C13.2, R9.2
unnamed: C17.2, R20.2
unnamed: D1.2 (A), JP1.1, JP1.2
unnamed: D2.1 (K), JP1.9, JP1.10
unnamed: D4.2 (A), Q6.3 (G), R12.1
unnamed: D4.1 (K), IC1.8
unnamed: D6.2 (A), Q9.3 (G), R33.1
unnamed: D6.1 (K), IC2.8
unnamed: D12.2 (A), Q1.3 (G), R29.1
unnamed: D12.1 (K), IC3.8
unnamed: IC1.1, IC1.2 (-), Q6.2 (D), R12.2
unnamed: IC1.6 (-), R3.2, R9.1
unnamed: IC1.10 (+), R15.2, R17.2
unnamed: IC1.9 (-), R14.1, R18.2
unnamed: C15.1, IC1.12 (+), Q6.1 (S)
unnamed: IC2.1, IC2.2 (-), Q9.2 (D), R33.2
unnamed: IC2.6 (-), R19.2, R20.1
unnamed: IC2.10 (+), R36.2, R38.2
unnamed: IC2.9 (-), R35.1, R39.2
unnamed: C19.1, IC2.12 (+), Q9.1 (S)
unnamed: IC3.1, IC3.2 (-), Q1.2 (D), R29.2
unnamed: IC3.6 (-), R27.2, R32.1
unnamed: IC3.10 (+), R23.2, R28.2
unnamed: IC3.9 (-), R25.2, R26.1
unnamed: C12.1, IC3.12 (+), Q1.1 (S)
unnamed: J4.P3 (3), R11.1
unnamed: J8.P3 (3), R22.1
unnamed: C3.1, J10.P3 (3), R7.2
unnamed: J9.P2 (2), J11.P3 (3), R6.1
unnamed: J12.P3 (3), R8.1
unnamed: J3.P3 (3), J13.P2 (2), R10.1
unnamed: J7.P3 (3), J14.P2 (2), R21.1
unnamed: C16.1, J16.P3 (3), R16.2
unnamed: C20.1, J17.P3 (3), R37.2
unnamed: Q2.1 (B), Q3.1 (B)
unnamed: C10.1, Q2.2 (E), R30.2
unnamed: C11.1, Q3.3 (C), R31.1
unnamed: Q4.1 (B), Q5.1 (B)
unnamed: C14.1, Q4.2 (E), R1.2
unnamed: C13.1, Q5.3 (C), R2.1
unnamed: Q7.1 (B), Q8.1 (B)
unnamed: C18.1, Q7.2 (E), R4.2
unnamed: C17.1, Q8.3 (C), R5.1
NoiseB: IC1.7, IC2.7, IC3.7, J2.1, J6.1, J15.1, R3.1, R19.1, R27.1
NoiseT: J1.1, J5.1, J18.1, R6.2, R10.2, R21.2
SHInB: IC1.3 (+), IC2.3 (+), IC3.3 (+), J2.4, J6.4, J15.4, R13.1, R24.1, R34.1
SHInT: J1.4, J5.4, J9.P3 (3), J13.P3 (3), J14.P3 (3), J18.4
SHOutB: IC1.13 (-), IC1.14, IC2.13 (-), IC2.14, IC3.13 (-), IC3.14, J2.3, J6.3, J15.3
SHOutT: J1.3, J5.3, J18.3, R8.2, R11.2, R22.2
TrigInB: J2.5, J6.5, J15.5, R15.1, R23.1, R36.1
TrigInT: C3.2, C16.2, C20.2, D3.1 (K), D5.1 (K), D7.1 (K), J1.5, J5.5, J18.5
VCC: C2.1, C5.1, C6.1, C8.1, D1.1 (K), IC1.4 (V+), IC2.4 (V+), IC3.4 (V+), R1.1, R2.2, R4.1, R5.2, R14.2, R26.2, R30.1, R31.2, R35.2
VEE: C1.2, C4.2, C7.2, C9.2, D2.2 (A), IC1.11 (V-), IC2.11 (V-), IC3.11 (V-)
