kstammits/Mutable/Kinks/k2.kicad_pcb

## KiCad design Kinks/k2.kicad_pcb (2026-11-04)

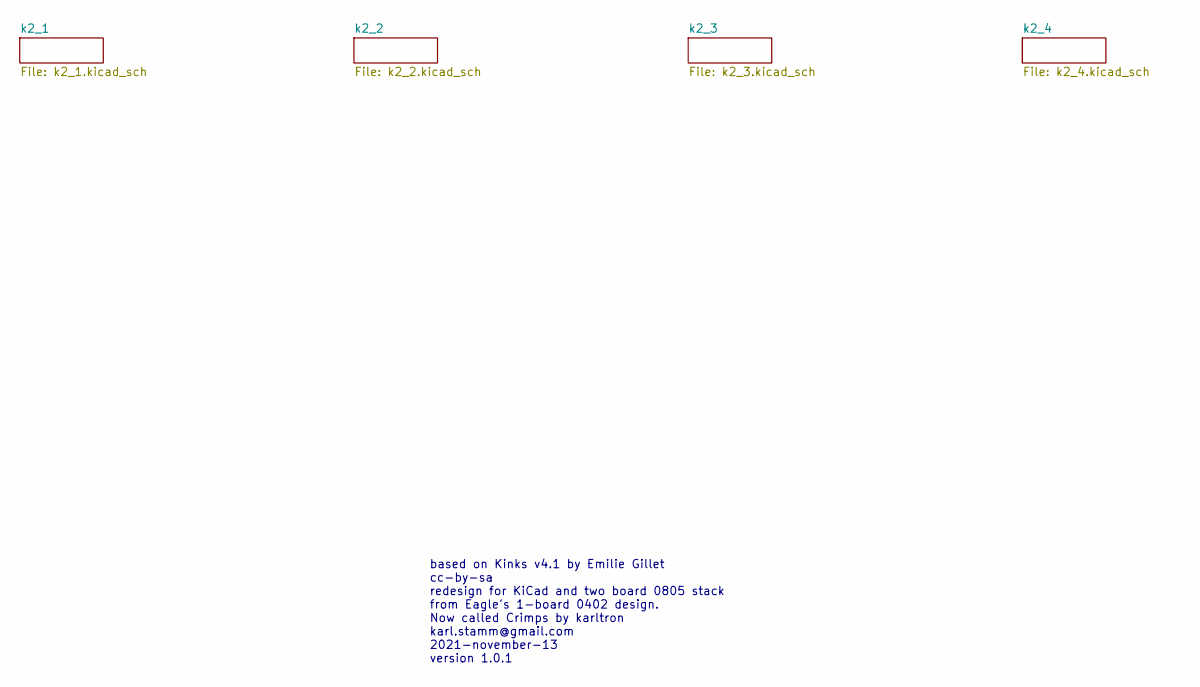
[picture p15: schematic k2.kicad_sch]

Notes on the sheet:
based on Kinks v4.1 by Emilie Gillet cc-by-sa redesign for KiCad and two board 0805 stack from Eagle's 1-board 0402 design. Now called Crimps by karltron karl.stamm@gmail.com 2021-november-13 version 1.0.1

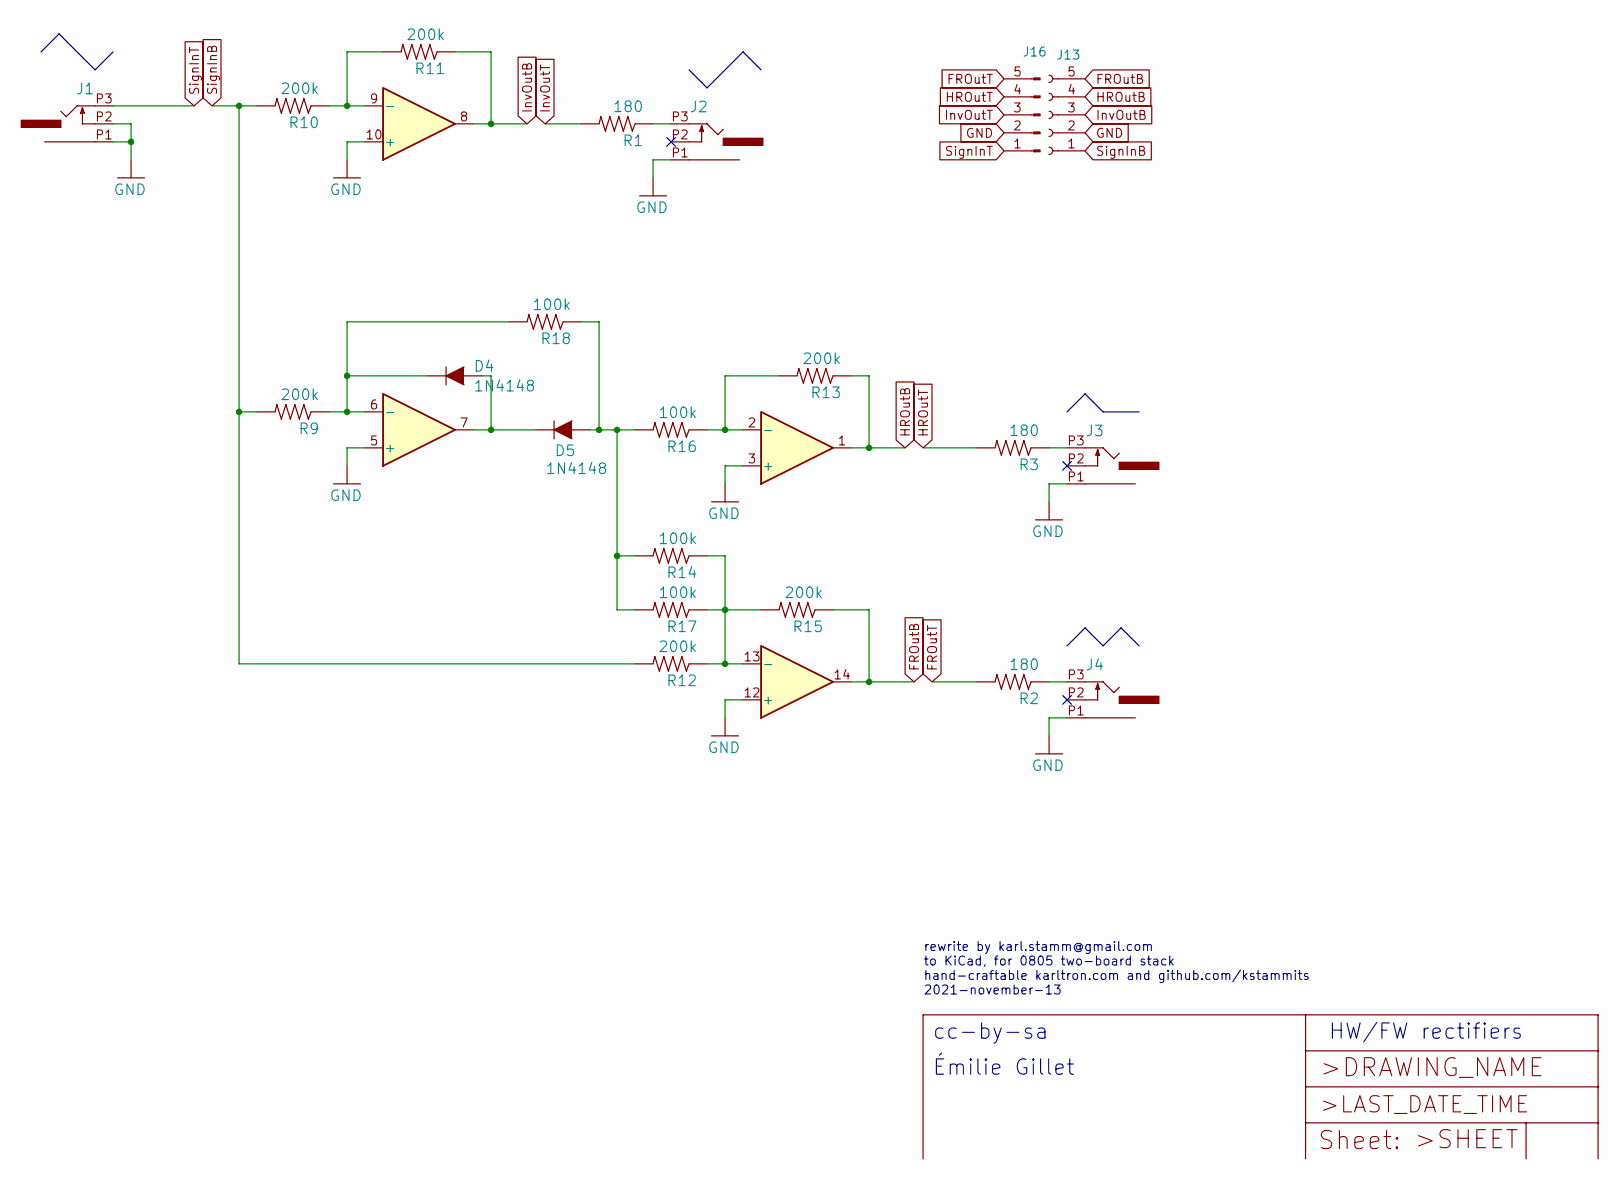
[picture p16: schematic k2_1.kicad_sch]

Parts:
D4, D5: 1N4148; D_1206_3216Metric_Pad1.42x1.75mm_HandSolder
IC1: TL074; SOIC-14_3.9x8.7mm_P1.27mm
J1, J2, J3, J4: PJ301_THONKICONN6; WQP_PJ_301M6
J13: Conn_01x05_Female; PinHeader_1x05_P2.54mm_Vertical
J16: Conn_01x05_Male; PinHeader_1x05_P2.54mm_Vertical
R1, R2, R3: 180; R_0805_2012Metric_Pad1.20x1.40mm_HandSolder
R9, R10, R11, R12, R13, R15: 200k; R_0805_2012Metric_Pad1.20x1.40mm_HandSolder
R14, R16, R17, R18: 100k; R_0805_2012Metric_Pad1.20x1.40mm_HandSolder

Connections:
FROutB: IC1.14, J13.5, R15.1
FROutT: J16.5, R2.2
GND: IC1.3 (+), IC1.5 (+), IC1.10 (+), IC1.12 (+), J1.P1 (1), J1.P2 (2), J2.P1 (1), J3.P1 (1), J4.P1 (1), J13.2, J16.2; also elsewhere on the board
HROutB: IC1.1, J13.4, R13.1
HROutT: J16.4, R3.2
InvOutB: IC1.8, J13.3, R11.1
InvOutT: J16.3, R1.2
unnamed: D4.2 (A), D5.1 (K), IC1.7
unnamed: D4.1 (K), IC1.6 (-), R9.1, R18.2
unnamed: D5.2 (A), R14.2, R16.2, R17.2, R18.1
unnamed: IC1.2 (-), R13.2, R16.1
unnamed: IC1.9 (-), R10.1, R11.2
unnamed: IC1.13 (-), R12.1, R14.1, R15.2, R17.1
unnamed: J2.P3 (3), R1.1
unnamed: J3.P3 (3), R3.1
unnamed: J4.P3 (3), R2.1
SignInB: J13.1, R9.2, R10.2, R12.2
SignInT: J1.P3 (3), J16.1

Notes on the sheet:
Émilie Gillet
HW/FW rectifiers
rewrite by karl.stamm@gmail.com to KiCad, for 0805 two-board stack hand-craftable karltron.com and github.com/kstammits 2021-november-13
cc-by-sa

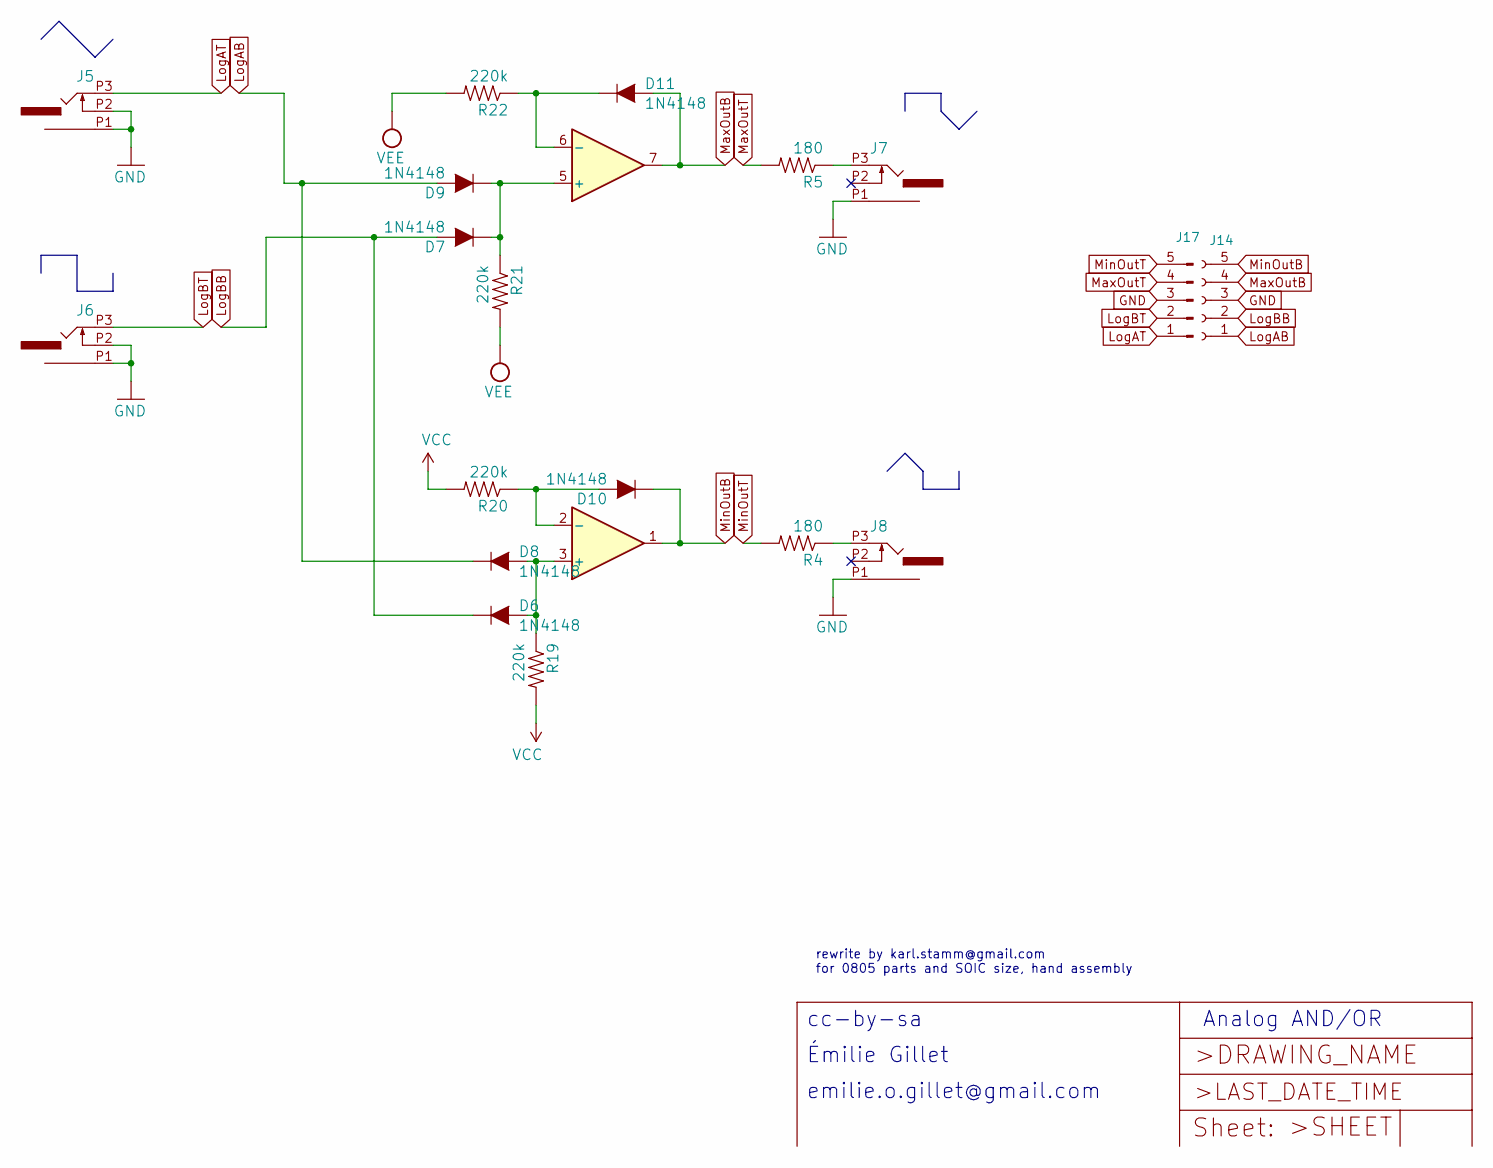
[picture p17: schematic k2_2.kicad_sch]

Parts:
D6, D7, D8, D9, D10, D11: 1N4148; D_1206_3216Metric_Pad1.42x1.75mm_HandSolder
IC2: TL072; SOIC-8_3.9x4.9mm_P1.27mm
J5, J6, J7, J8: PJ301_THONKICONN6; WQP_PJ_301M6
J14: Conn_01x05_Female; PinHeader_1x05_P2.54mm_Vertical
J17: Conn_01x05_Male; PinHeader_1x05_P2.54mm_Vertical
R4, R5: 180; R_0805_2012Metric_Pad1.20x1.40mm_HandSolder
R19, R20, R21, R22: 220k; R_0805_2012Metric_Pad1.20x1.40mm_HandSolder

Connections:
GND: J5.P1 (1), J5.P2 (2), J6.P1 (1), J6.P2 (2), J7.P1 (1), J8.P1 (1), J14.3, J17.3; also elsewhere on the board
LogAB: D8.1 (K), D9.2 (A), J14.1
LogAT: J5.P3 (3), J17.1
LogBB: D6.1 (K), D7.2 (A), J14.2
LogBT: J6.P3 (3), J17.2
MaxOutB: D11.2 (A), IC2.7, J14.4
MaxOutT: J17.4, R5.2
MinOutB: D10.1 (K), IC2.1, J14.5
MinOutT: J17.5, R4.2
unnamed: D6.2 (A), D8.2 (A), IC2.3 (+), R19.1
unnamed: D7.1 (K), D9.1 (K), IC2.5 (+), R21.1
unnamed: D10.2 (A), IC2.2 (-), R20.1
unnamed: D11.1 (K), IC2.6 (-), R22.1
unnamed: J7.P3 (3), R5.1
unnamed: J8.P3 (3), R4.1
VCC: R19.2, R20.2; also elsewhere on the board
VEE: R21.2, R22.2; also elsewhere on the board

Notes on the sheet:
emilie.o.gillet@gmail.com
cc-by-sa
Émilie Gillet
rewrite by karl.stamm@gmail.com for 0805 parts and SOIC size, hand assembly
Analog AND/OR

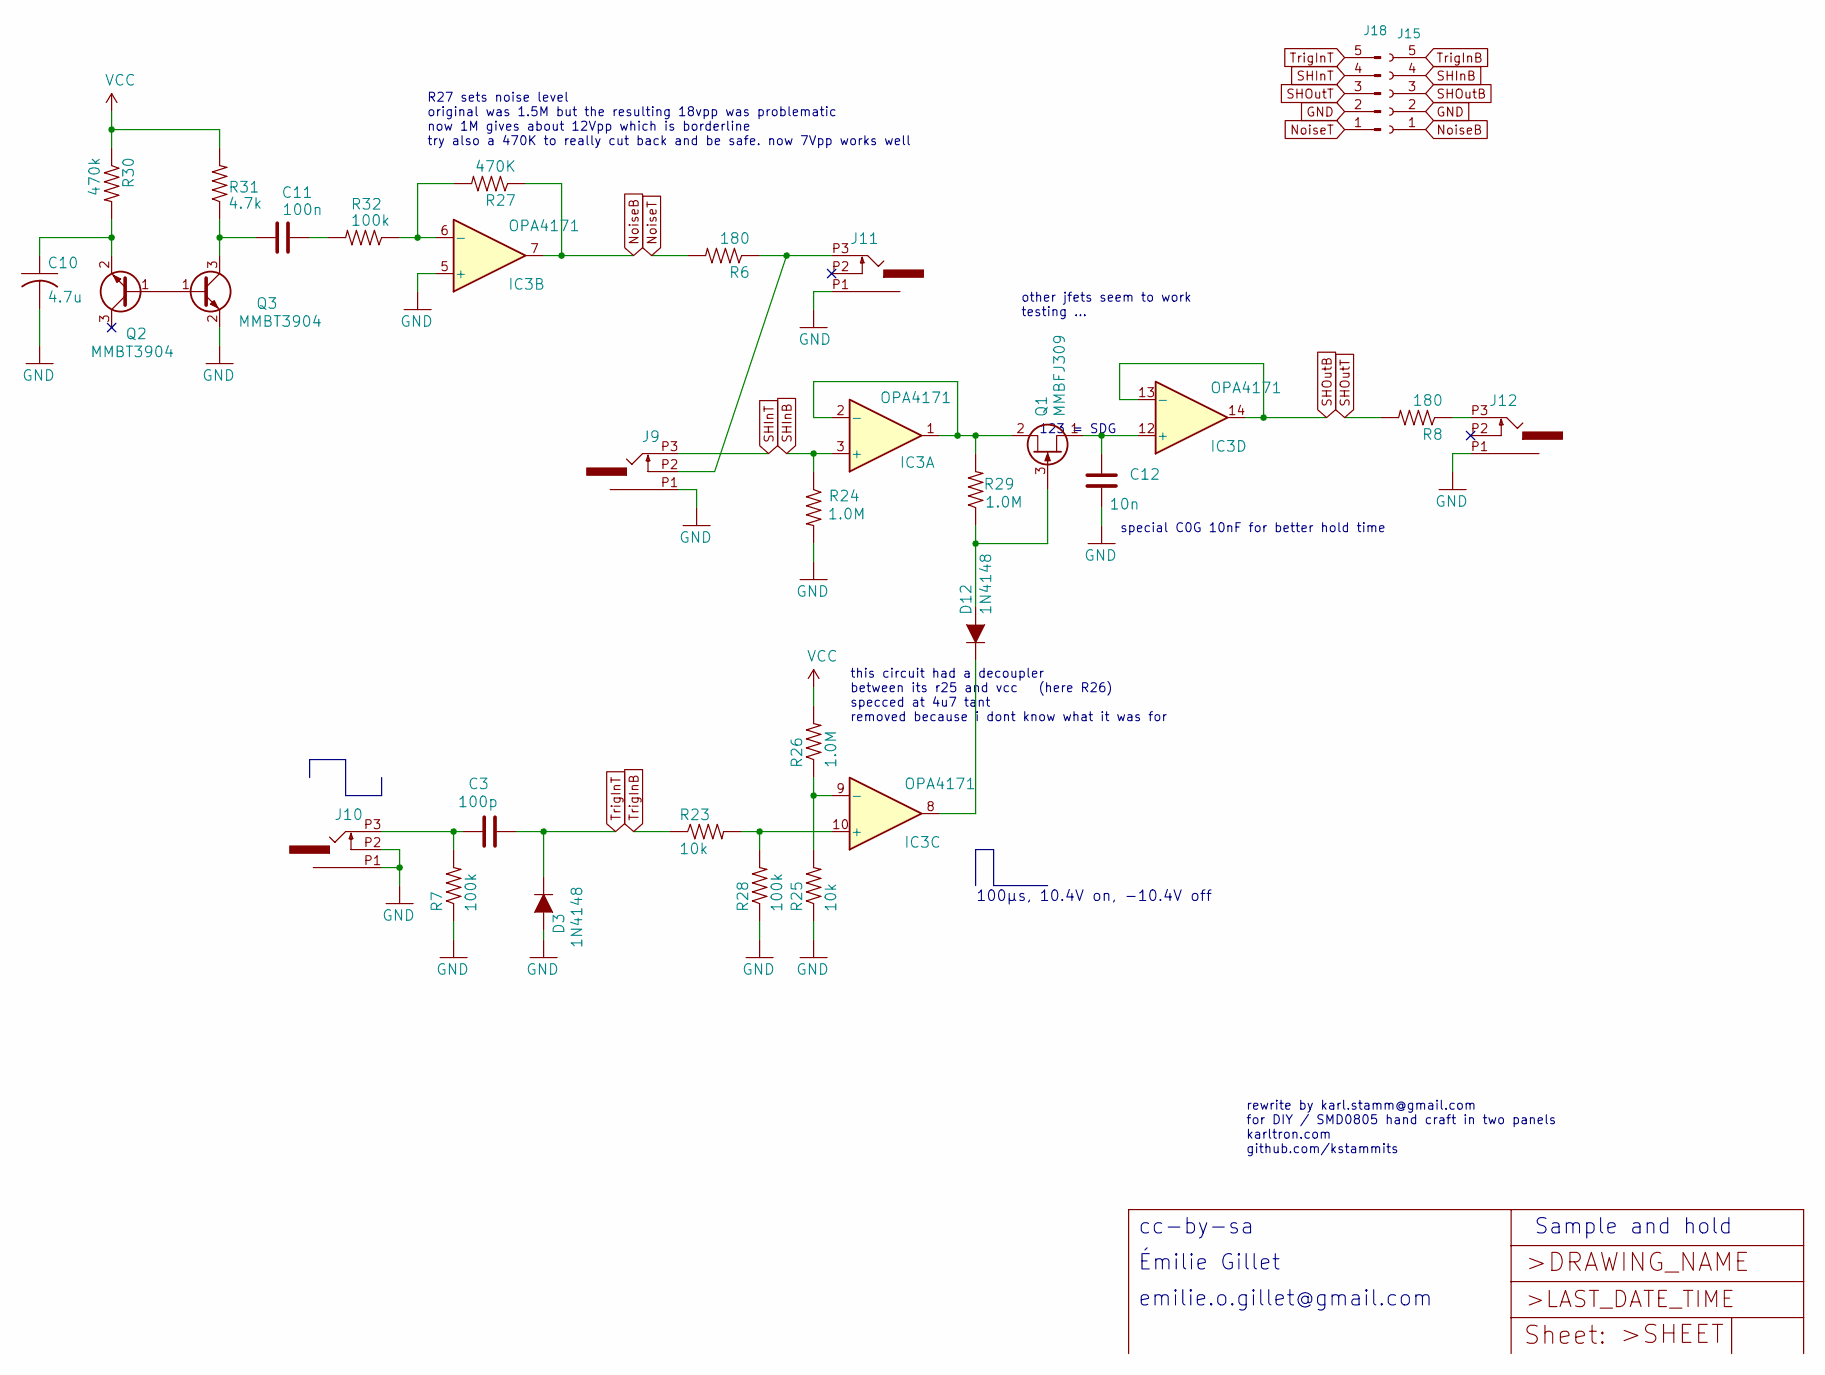
[picture p18: schematic k2_3.kicad_sch, Crimps]

Parts:
C3: 100p; C_0805_2012Metric_Pad1.18x1.45mm_HandSolder
C10: 4.7u; C_0805_2012Metric_Pad1.18x1.45mm_HandSolder
C11: 100n; C_0805_2012Metric_Pad1.18x1.45mm_HandSolder
C12: 10n; C_0805_2012Metric_Pad1.18x1.45mm_HandSolder
D3, D12: 1N4148; D_1206_3216Metric_Pad1.42x1.75mm_HandSolder
IC3: OPA4171; SOIC-14_3.9x8.7mm_P1.27mm
J9, J10, J11, J12: PJ301_THONKICONN6; WQP_PJ_301M6
J15: Conn_01x05_Female; PinHeader_1x05_P2.54mm_Vertical
J18: Conn_01x05_Male; PinHeader_1x05_P2.54mm_Vertical
Q1: MMBFJ309; SOT-23_Handsoldering
Q2, Q3: MMBT3904; SOT-23_Handsoldering
R6, R8: 180; R_0805_2012Metric_Pad1.20x1.40mm_HandSolder
R7, R28, R32: 100k; R_0805_2012Metric_Pad1.20x1.40mm_HandSolder
R23, R25: 10k; R_0805_2012Metric_Pad1.20x1.40mm_HandSolder
R24, R26, R29: 1.0M; R_0805_2012Metric_Pad1.20x1.40mm_HandSolder
R27: 470K; R_0805_2012Metric_Pad1.20x1.40mm_HandSolder
R30: 470k; R_0805_2012Metric_Pad1.20x1.40mm_HandSolder
R31: 4.7k; R_0805_2012Metric_Pad1.20x1.40mm_HandSolder

Connections:
GND: C10.2, C12.2, D3.2 (A), IC3.5 (+), J9.P1 (1), J10.P1 (1), J10.P2 (2), J11.P1 (1), J12.P1 (1), J15.2, J18.2, Q3.2 (E), R7.1, R24.2, R25.1, R28.1; also elsewhere on the board
unnamed: C11.2, R32.2
unnamed: D12.2 (A), Q1.3 (G), R29.1
unnamed: D12.1 (K), IC3.8
unnamed: IC3.1, IC3.2 (-), Q1.2 (D), R29.2
unnamed: IC3.6 (-), R27.2, R32.1
unnamed: IC3.10 (+), R23.2, R28.2
unnamed: IC3.9 (-), R25.2, R26.1
unnamed: C12.1, IC3.12 (+), Q1.1 (S)
unnamed: C3.1, J10.P3 (3), R7.2
unnamed: J9.P2 (2), J11.P3 (3), R6.1
unnamed: J12.P3 (3), R8.1
unnamed: Q2.1 (B), Q3.1 (B)
unnamed: C10.1, Q2.2 (E), R30.2
unnamed: C11.1, Q3.3 (C), R31.1
NoiseB: IC3.7, J15.1, R27.1
NoiseT: J18.1, R6.2
SHInB: IC3.3 (+), J15.4, R24.1
SHInT: J9.P3 (3), J18.4
SHOutB: IC3.13 (-), IC3.14, J15.3
SHOutT: J18.3, R8.2
TrigInB: J15.5, R23.1
TrigInT: C3.2, D3.1 (K), J18.5
VCC: R26.2, R30.1, R31.2; also elsewhere on the board

Notes on the sheet:
special C0G 10nF for better hold time
rewrite by karl.stamm@gmail.com for DIY / SMD0805 hand craft in two panels karltron.com github.com/kstammits
cc-by-sa
100µs, 10.4V on, -10.4V off
this circuit had a decoupler between its r25 and vcc (here R26) specced at 4u7 tant removed because i dont know what it was for
Émilie Gillet
123 = SDG
emilie.o.gillet@gmail.com
R27 sets noise level original was 1.5M but the resulting 18vpp was problematic now 1M gives about 12Vpp which is borderline try also a 470K to really cut back and be safe. now 7Vpp works well
Sample and hold
other jfets seem to work testing ...
