kstammits/Mutable/Kinks/k2.kicad_pcb

## KiCad design Kinks/k2.kicad_pcb (continued)

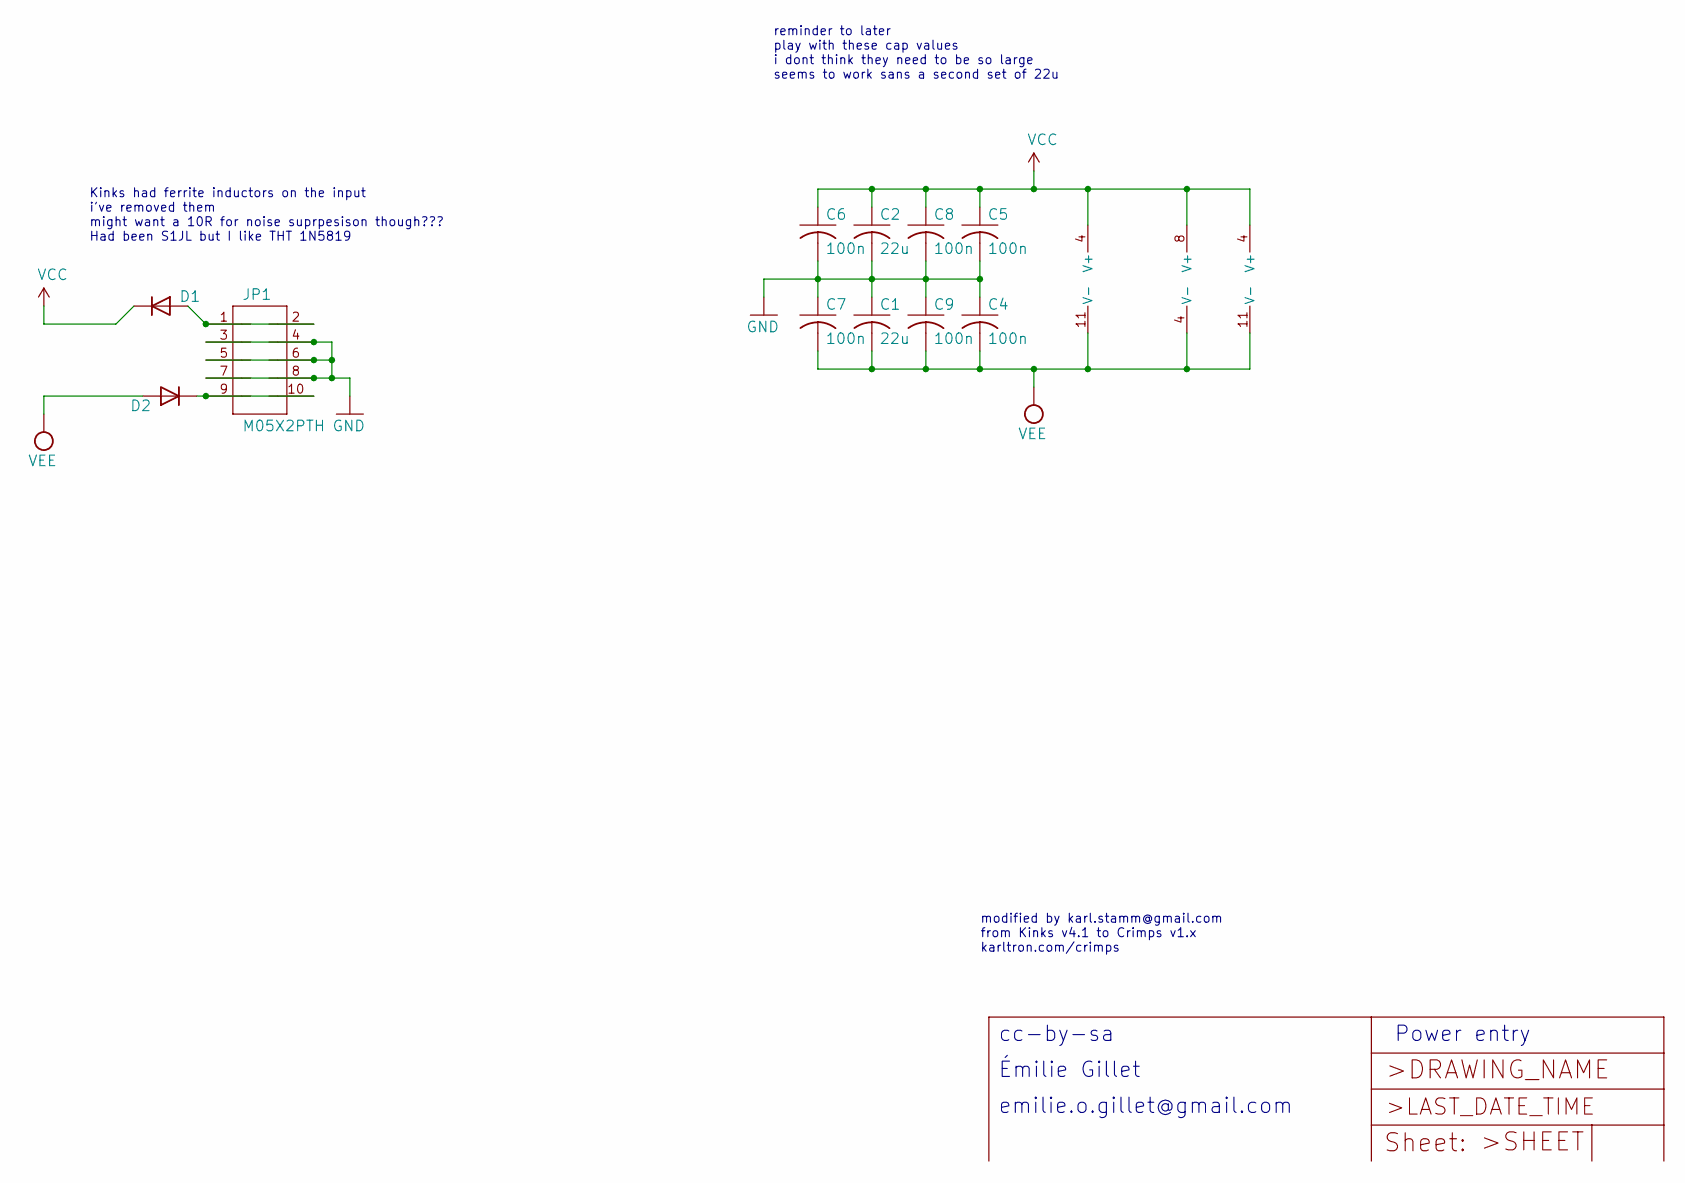
[picture p19: schematic k2_4.kicad_sch]

Parts:
C1, C2: 22u; CP_Radial_D6.3mm_P2.50mm
C4, C5, C6, C7, C8, C9: 100n; C_0805_2012Metric_Pad1.18x1.45mm_HandSolder
D1, D2: S1JL; D_DO-41_SOD81_P10.16mm_Horizontal
IC1: TL074; SOIC-14_3.9x8.7mm_P1.27mm
IC2: TL072; SOIC-8_3.9x4.9mm_P1.27mm
IC3: OPA4171; SOIC-14_3.9x8.7mm_P1.27mm
JP1: M05X2PTH; AVR_ICSP

Connections:
GND: C1.1, C2.2, C4.1, C5.2, C6.2, C7.1, C8.2, C9.1, JP1.3, JP1.4, JP1.5, JP1.6, JP1.7, JP1.8; also elsewhere on the board
unnamed: D1.2 (A), JP1.1, JP1.2
unnamed: D2.1 (K), JP1.9, JP1.10
VCC: C2.1, C5.1, C6.1, C8.1, D1.1 (K), IC1.4 (V+), IC2.8 (V+), IC3.4 (V+); also elsewhere on the board
VEE: C1.2, C4.2, C7.2, C9.2, D2.2 (A), IC1.11 (V-), IC2.4 (V-), IC3.11 (V-); also elsewhere on the board

Notes on the sheet:
Émilie Gillet
Kinks had ferrite inductors on the input i've removed them might want a 10R for noise suprpesison though??? Had been S1JL but I like THT 1N5819
Power entry
cc-by-sa
reminder to later play with these cap values i dont think they need to be so large seems to work sans a second set of 22u
modified by karl.stamm@gmail.com from Kinks v4.1 to Crimps v1.x karltron.com/crimps
emilie.o.gillet@gmail.com

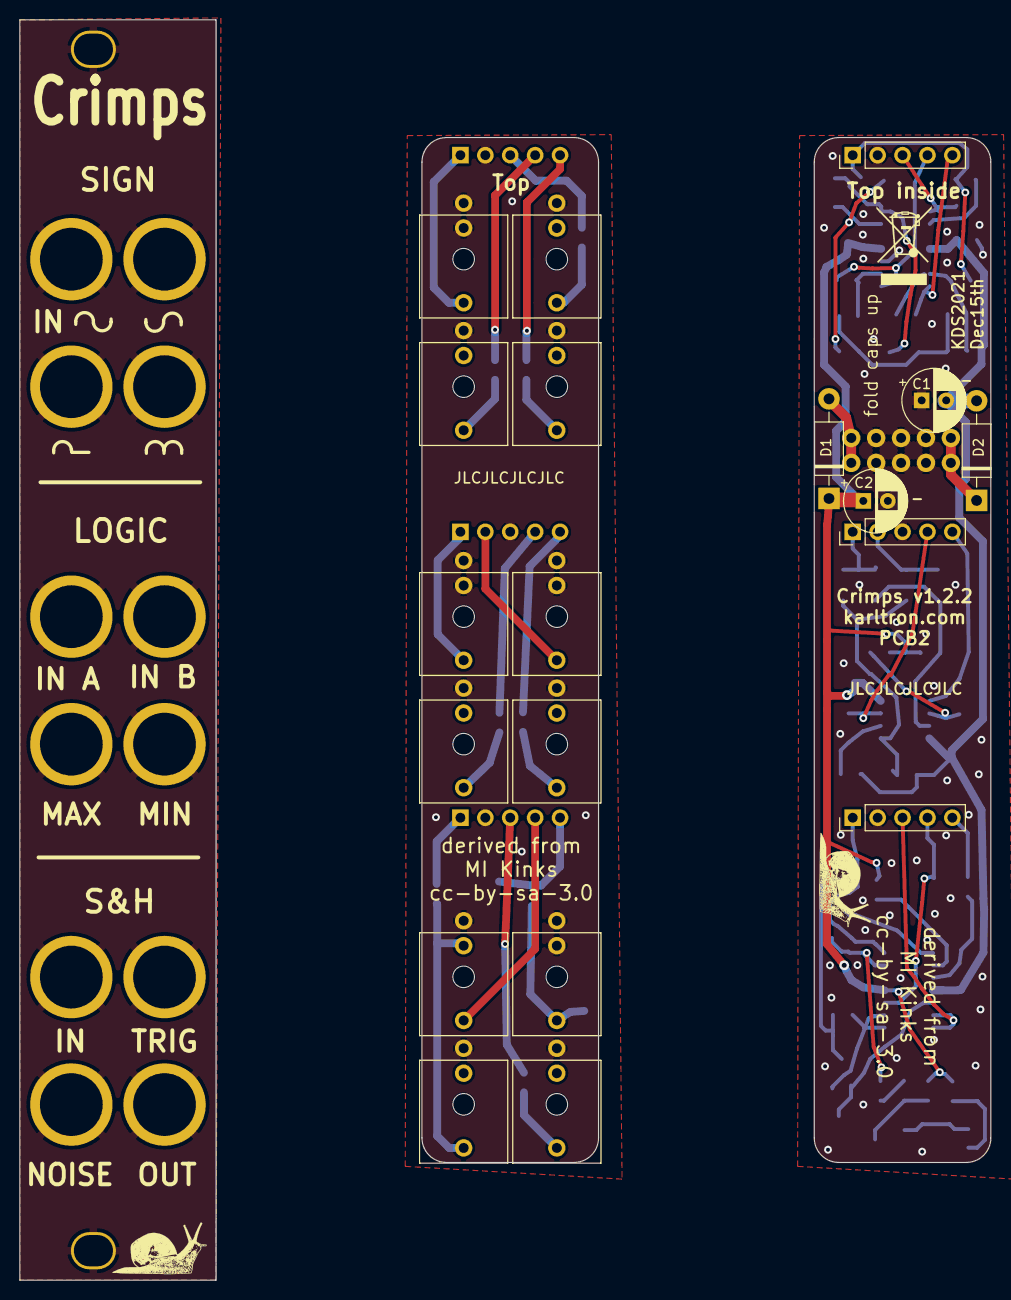
[picture p20: board k2.kicad_pcb from above]

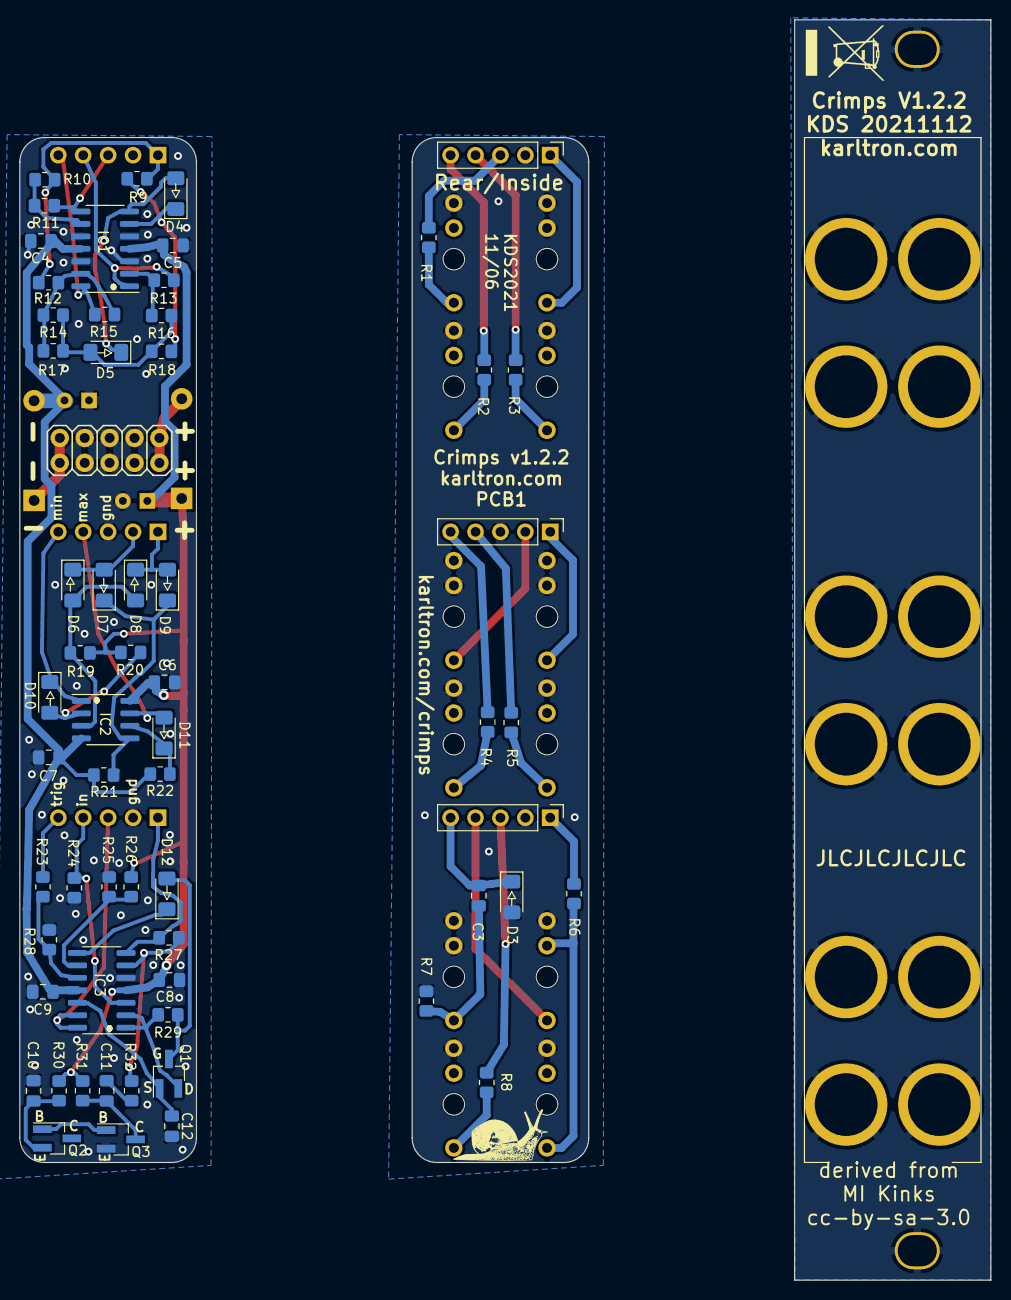
[picture p21: board k2.kicad_pcb from below]

Board: 2 copper layers, 99.0 x 128.5 mm, 96 parts (62 on the bottom side), 58 nets.

Other parts of the board:
G1: Logo_Open_Hardware_Small; snail4.sm
H1, H14: MountingHole_Pad; SLOT-1
H2, H2#2, H2#3, H2#4, H2#5, H2#6, H2#7, H2#8, H2#9: J1; MountingHole_6.4mm_M6_Pad
H6, H6#2, H6#3: J2; MountingHole_6.4mm_M6_Pad

Their connections:
GND: H1.1, H2.1, H2#2.1, H2#3.1, H2#4.1, H2#5.1, H2#6.1, H2#7.1, H2#8.1, H2#9.1, H6.1, H6#2.1, H6#3.1, H14.1; also elsewhere on the board
