kstammits/Mutable/Shades/Shady.kicad_pcb

## KiCad design Shades/Shady.kicad_pcb (2026-11-04)

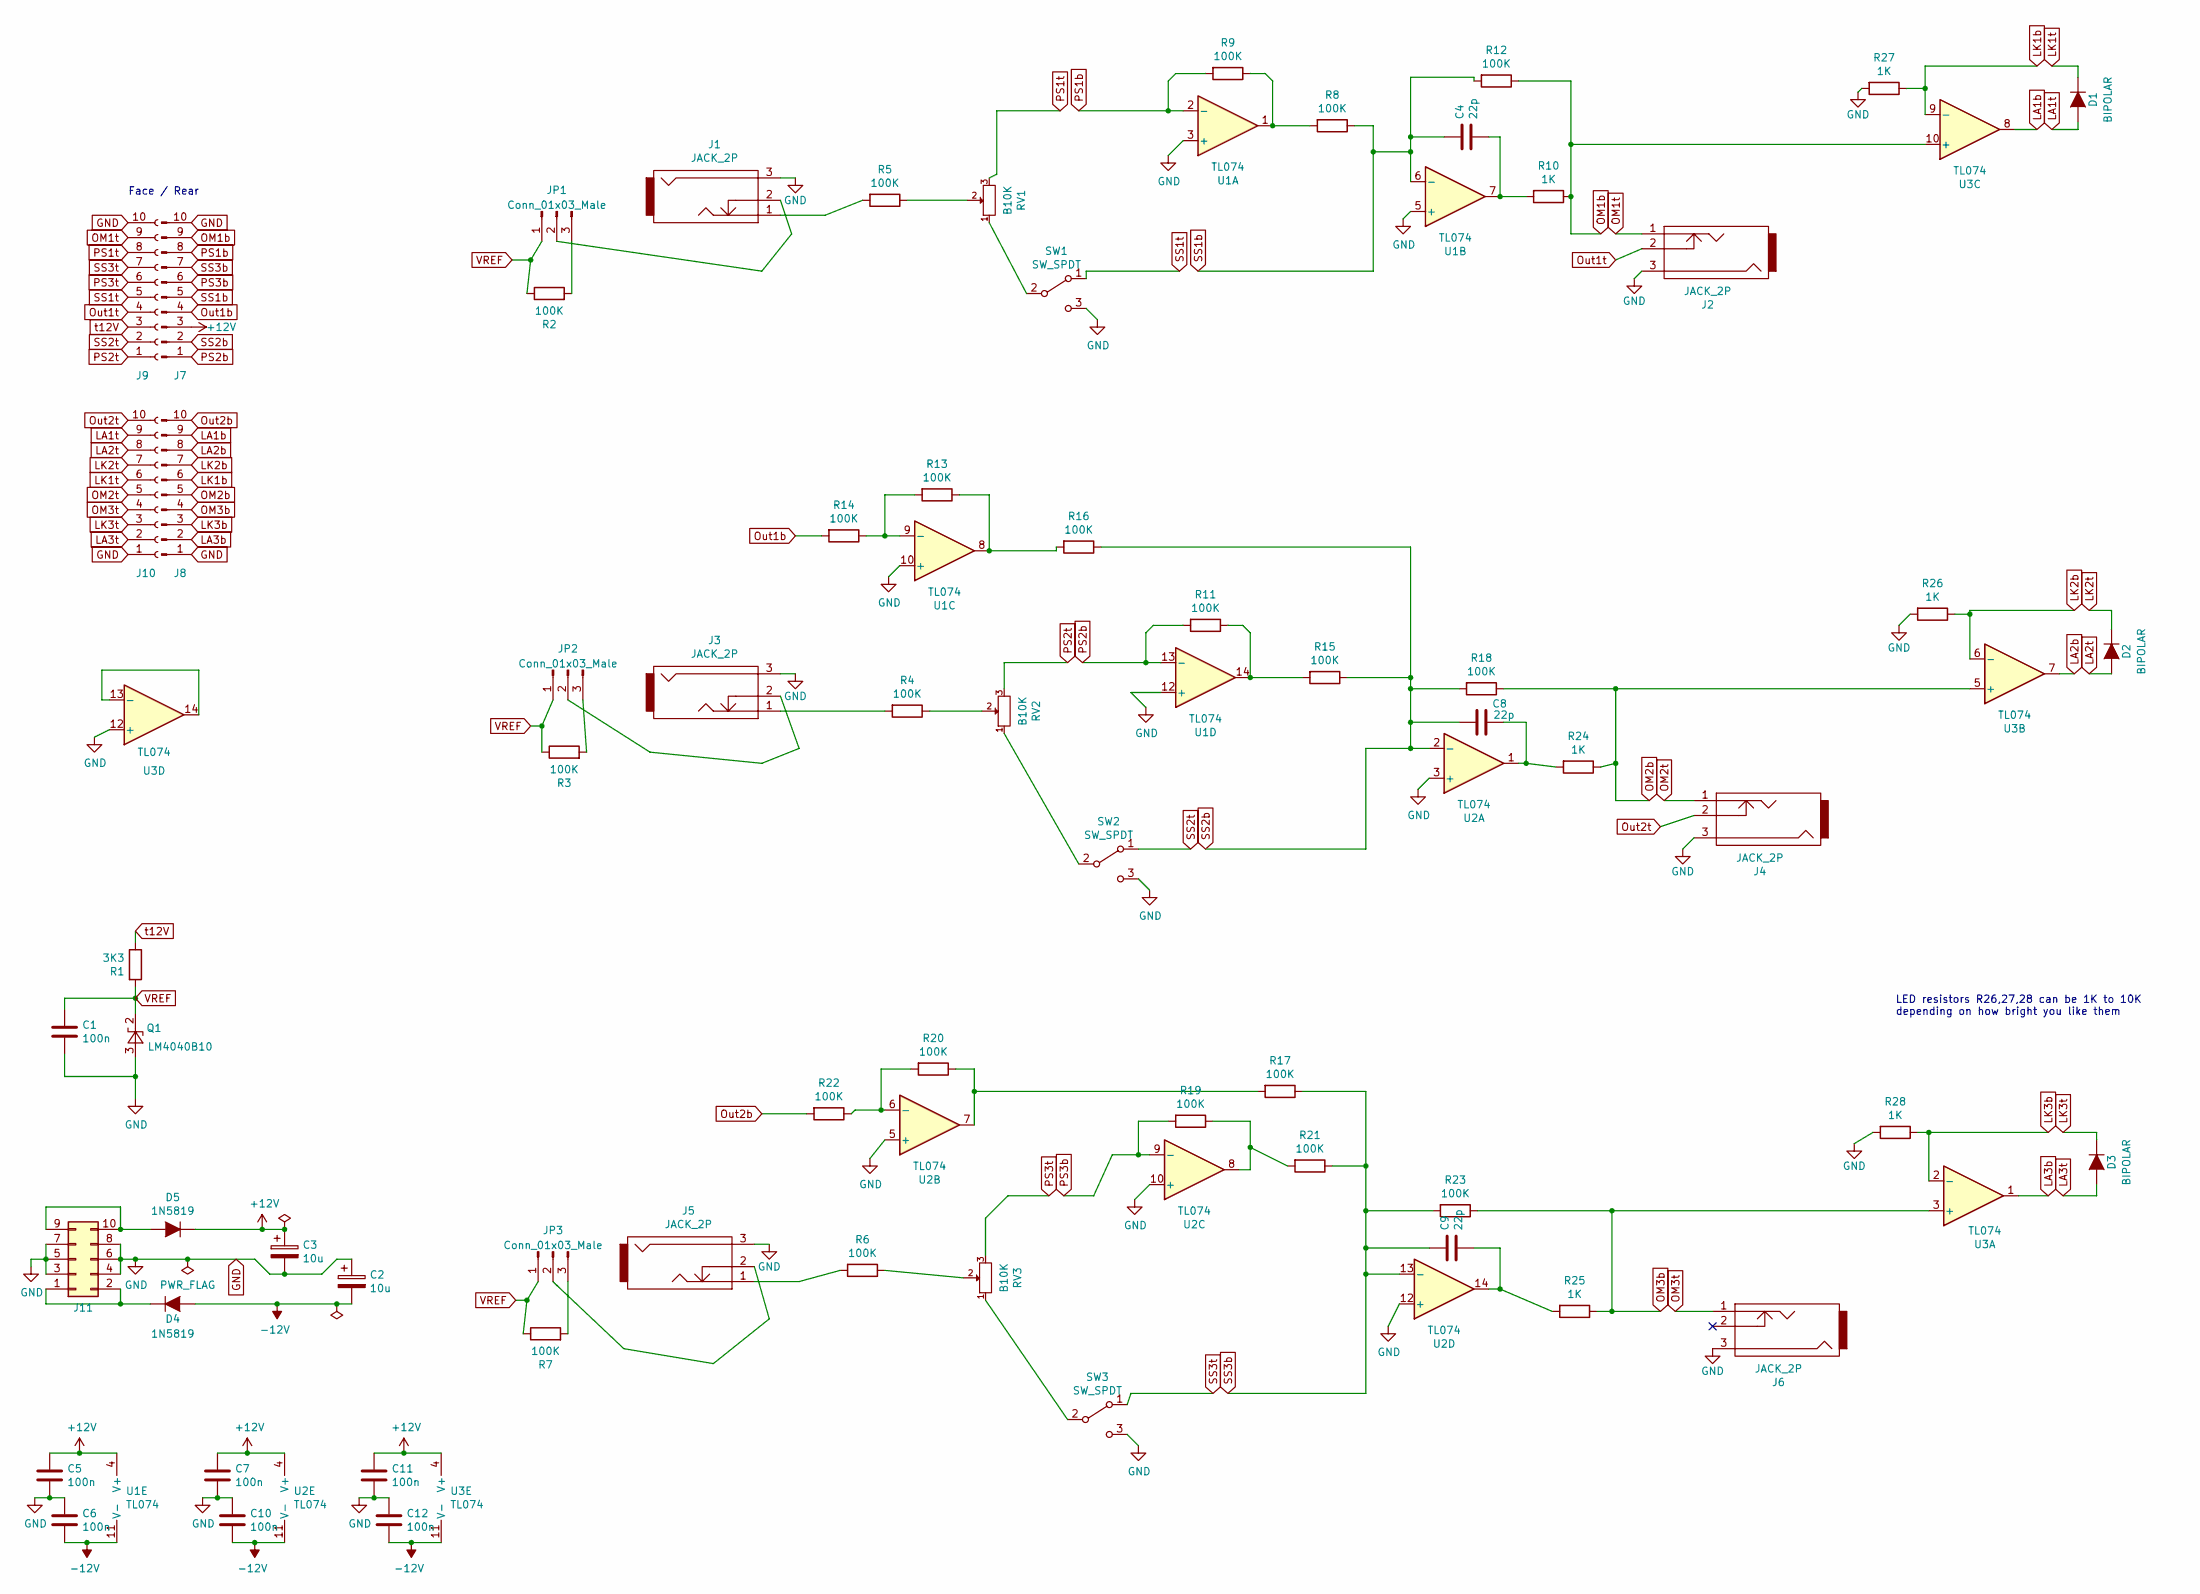
[picture p22: schematic Shady.kicad_sch]

Parts:
C1, C5, C6, C7, C10, C11, C12: 100n; C_Disc_D5.0mm_W2.5mm_P2.50mm
C2, C3: 10u; CP_Radial_D5.0mm_P2.50mm
C4, C8, C9: 22p; C_Disc_D3.0mm_W2.0mm_P2.50mm
D1, D2, D3: BIPOLAR; LED_D5.0mm
D4, D5: 1N5819; D_DO-41_SOD81_P10.16mm_Horizontal
J1, J2, J3, J4, J5, J6: JACK_2P; Thonkiconn
J7, J8: Conn_01x10_Male; PinHeader_1x10_P2.54mm_Vertical
J9, J10: Conn_01x10_Female; PinHeader_1x10_P2.54mm_Vertical
J11: Conn_02x05_Odd_Even; PinHeader_2x05_P2.54mm_Vertical
JP1, JP2, JP3: Conn_01x03_Male; PinHeader_1x03_P2.54mm_Horizontal
Q1: LM4040B10; TO-92_Inline_Wide
R1: 3K3; R_Axial_DIN0207_L6.3mm_D2.5mm_P2.54mm_Vertical
R2, R3, R4, R5, R6, R7, R8, R9, R11, R12, R13, R14, R15, R16, R17, R18, R19, R20, R21, R22, R23: 100K; R_Axial_DIN0207_L6.3mm_D2.5mm_P2.54mm_Vertical
R10, R24, R25, R26, R27, R28: 1K; R_Axial_DIN0207_L6.3mm_D2.5mm_P2.54mm_Vertical
RV1, RV2, RV3: B10K; Potentiometer_Alpha_RD901F-40-00D_Single_Vertical
SW1, SW2, SW3: SW_SPDT; SPDT_Tayda-A5111
U1, U2, U3: TL074; DIP-14_W7.62mm_Socket

Connections:
+12V: C3.1, C5.1, C7.1, C11.1, D5.1 (K), J7.3, U1.4 (V+), U2.4 (V+), U3.4 (V+)
-12V: C2.2, C6.2, C10.2, C12.2, D4.2 (A), U1.11 (V-), U2.11 (V-), U3.11 (V-)
GND: C1.2, C2.1, C3.2, C5.2, C6.1, C7.2, C10.1, C11.2, C12.1, J1.3, J2.3, J3.3, J4.3, J5.3, J6.3, J7.10, J8.1, J9.10, J10.1, J11.3, J11.4, J11.5, J11.6, J11.7, J11.8, Q1.3 (A), R26.2, R27.2, R28.2, SW1.3 (C), SW2.3 (C), SW3.3 (C), U1.3 (+), U1.5 (+), U1.10 (+), U1.12 (+), U2.3 (+), U2.5 (+), U2.10 (+), U2.12 (+), U3.12 (+)
LA1b: J8.9, U3.8
LA1t: D1.2 (A), J10.9
LA2b: J8.8, U3.7
LA2t: D2.2 (A), J10.8
LA3b: J8.2, U3.1
LA3t: D3.2 (A), J10.2
LK1b: J8.6, R27.1, U3.9 (-)
LK1t: D1.1 (K), J10.6
LK2b: J8.7, R26.1, U3.6 (-)
LK2t: D2.1 (K), J10.7
LK3b: J8.3, R28.1, U3.2 (-)
LK3t: D3.1 (K), J10.3
unnamed: C4.2, R10.2, U1.7
unnamed: C8.2, R24.2, U2.1
unnamed: C9.2, R25.2, U2.14
unnamed: D5.2 (A), J11.9, J11.10
unnamed: D4.1 (K), J11.1, J11.2
unnamed: J1.1, R5.2
unnamed: J1.2, JP1.2
unnamed: J3.1, R4.2
unnamed: J3.2, JP2.2
unnamed: J5.1, R6.2
unnamed: J5.2, JP3.2
unnamed: JP1.3, R2.2
unnamed: JP2.3, R3.2
unnamed: JP3.3, R7.2
unnamed: R5.1, RV1.2
unnamed: R13.2, R14.1, U1.9 (-)
unnamed: R8.2, R9.1, U1.1
unnamed: R13.1, R16.2, U1.8
unnamed: R11.1, R15.2, U1.14
unnamed: R4.1, RV2.2
unnamed: R17.2, R20.1, U2.7
unnamed: R20.2, R22.1, U2.6 (-)
unnamed: R19.1, R21.2, U2.8
unnamed: R6.1, RV3.2
unnamed: RV1.1, SW1.2 (B)
unnamed: RV2.1, SW2.2 (B)
unnamed: RV3.1, SW3.2 (B)
unnamed: U3.13 (-), U3.14
OM1b: J7.9, R10.1, R12.1, U3.10 (+)
OM1t: J2.1, J9.9
OM2b: J8.5, R18.1, R24.1, U3.5 (+)
OM2t: J4.1, J10.5
OM3b: J8.4, R23.1, R25.1, U3.3 (+)
OM3t: J6.1, J10.4
Out1b: J7.4, R14.2
Out1t: J2.2, J9.4
Out2b: J8.10, R22.2
Out2t: J4.2, J10.10
PS1b: J7.8, R9.2, U1.2 (-)
PS1t: J9.8, RV1.3
PS2b: J7.1, R11.2, U1.13 (-)
PS2t: J9.1, RV2.3
PS3b: J7.6, R19.2, U2.9 (-)
PS3t: J9.6, RV3.3
SS1b: C4.1, J7.5, R8.1, R12.2, U1.6 (-)
SS1t: J9.5, SW1.1 (A)
SS2b: C8.1, J7.2, R15.1, R16.1, R18.2, U2.2 (-)
SS2t: J9.2, SW2.1 (A)
SS3b: C9.1, J7.7, R17.1, R21.1, R23.2, U2.13 (-)
SS3t: J9.7, SW3.1 (A)
VREF: C1.1, JP1.1, JP2.1, JP3.1, Q1.2 (K), R1.2, R2.1, R3.1, R7.1
t12V: J9.3, R1.1

Notes on the sheet:
LED resistors R26,27,28 can be 1K to 10K depending on how bright you like them
Face / Rear

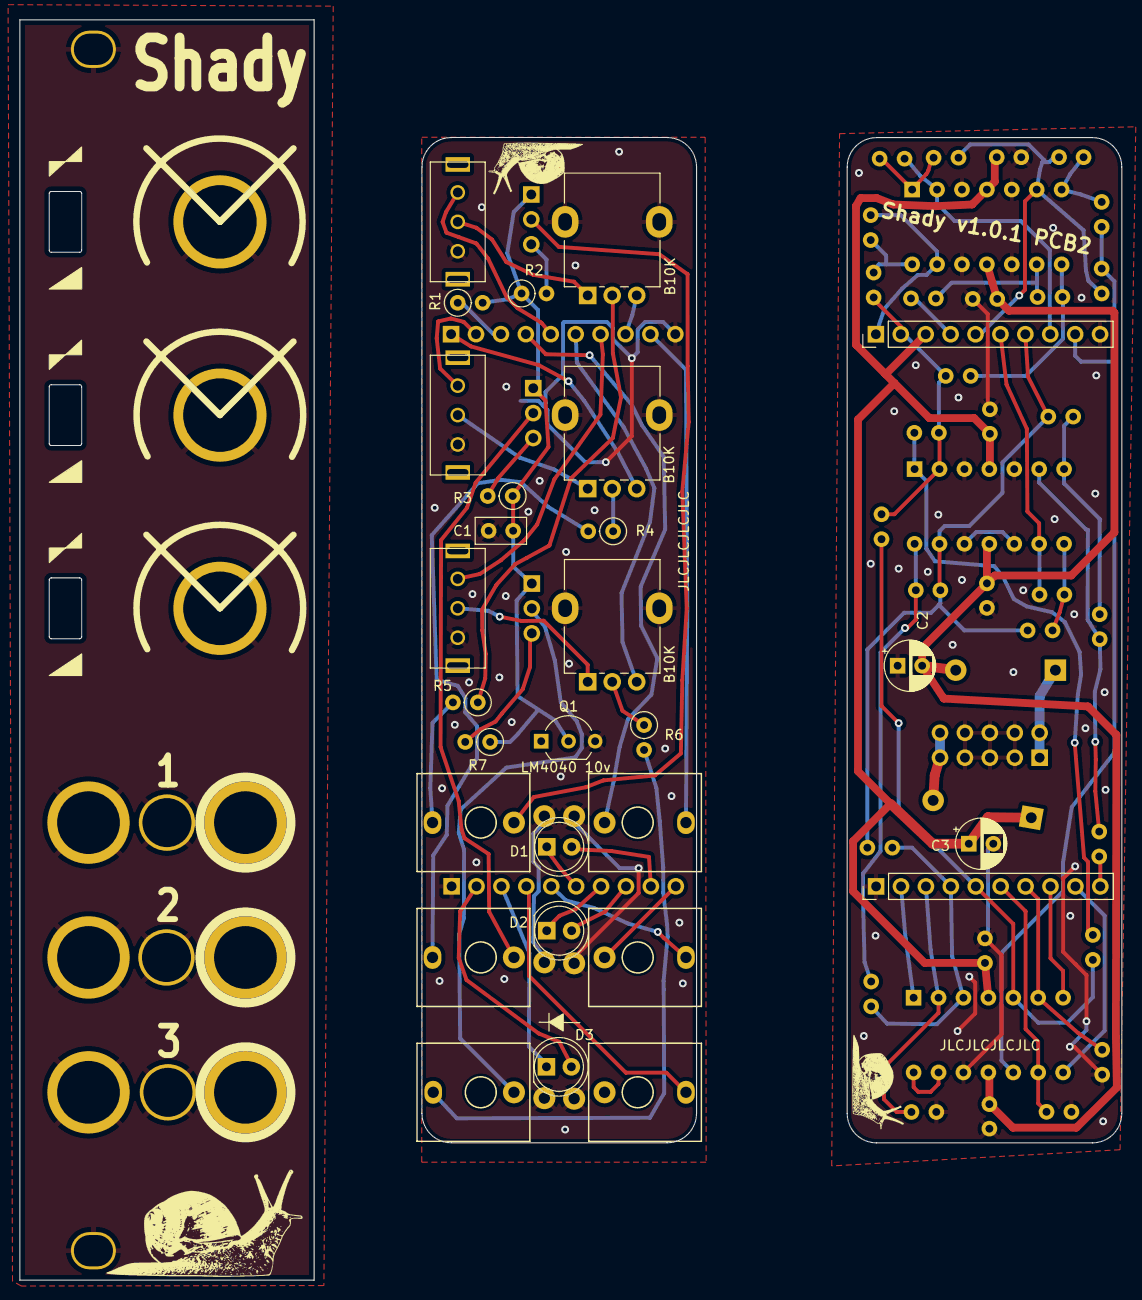
[picture p23: board Shady.kicad_pcb from above]

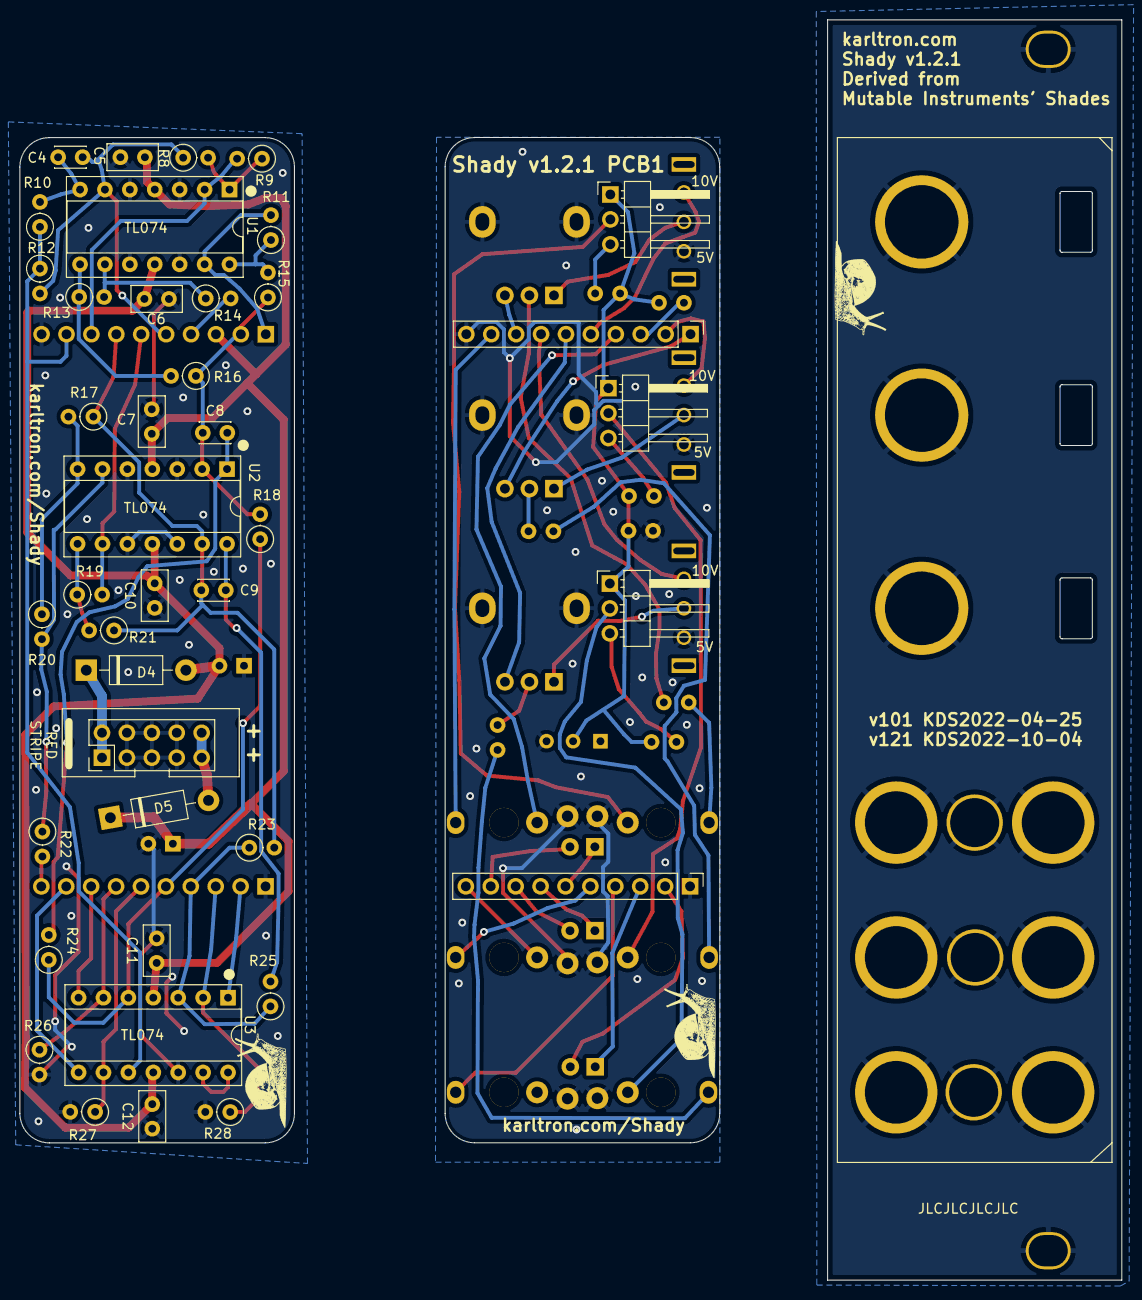
[picture p24: board Shady.kicad_pcb from below]

Board: 2 copper layers, 112.4 x 128.5 mm, 73 parts (43 on the bottom side), 67 nets.

Other parts of the board:
G1, G2, G3, G4: Logo_Open_Hardware_Small; snail4.sm
