kstammits/Mutable/(commit log)

2024-08-27 version of kicad
2026-11-04 and jinx
    [Jinx.kicad_pcb, Jinx.kicad_sch, k2_1.kicad_sch, k2_2.kicad_sch, k2_3.kicad_sch, k2_4.kicad_sch]
