kstammits/Mutable/(notices)

Notices in the files:
Jinx/Jinx.kicad_pcb:
cc-by-sa-3.0
Jinx/Jinx.kicad_sch:
cc-by-sa-3 viral
